Stormgears-FRC-5422/StormNet/2018/The Story/IMG_0521.jpg

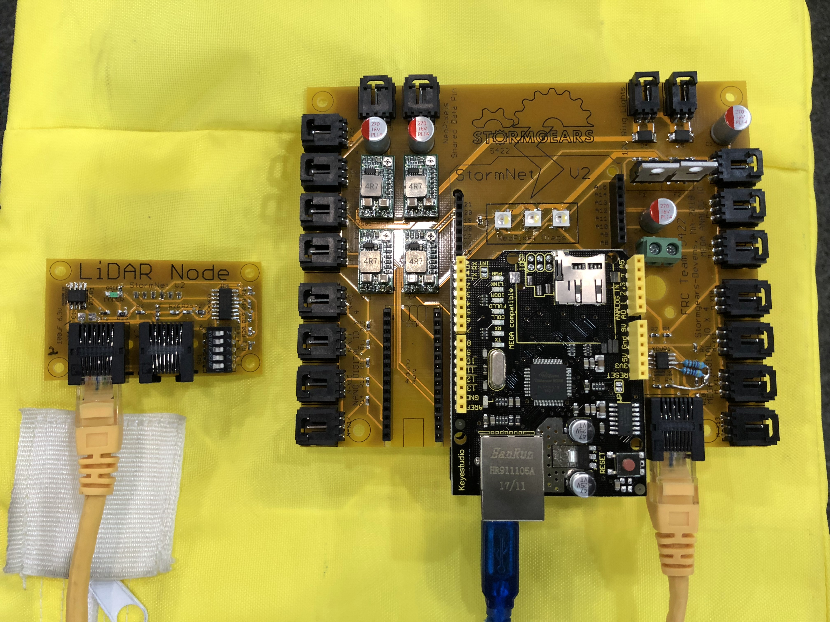
2018/The Story/IMG_0521.jpg
