Stormgears-FRC-5422/StormNet/README.md

# StormNet
Electrical schematics and other files related to the StormNet sensor board
