Stormgears-FRC-5422/StormNet/2020/StormNetGenericNodeSchematic.pdf

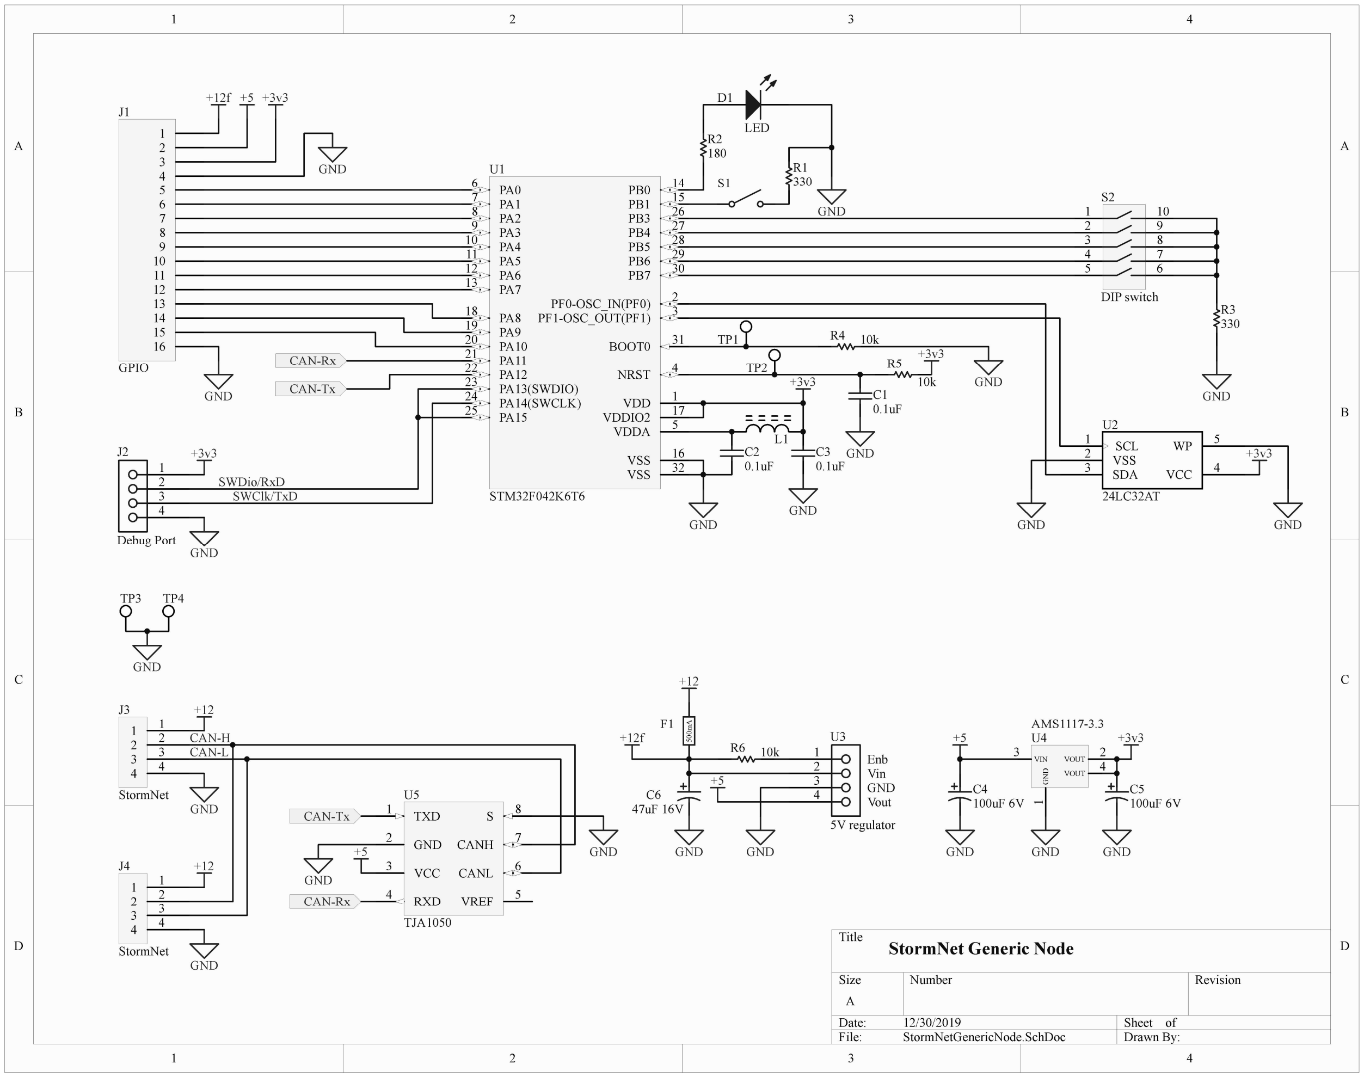
[picture p7: page 1]

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
Title

Size | Number | Revision
A
Date: | 12/30/2019 | Sheet of
File: | StormNetGenericNode.SchDoc | Drawn By:

PA0 6
PA1 7
PA2 8
PA3 9
PA4 10
PA5 11
PA6 12
PA7 13

PA8 18
PA9 19
PA10 20
PA11 21
PA12 22
PA13(SWDIO) 23
PA14(SWCLK) 24
PA15 25
PB0 | 14
PB1 | 15
PB3 | 26
PB4 | 27
PB5 | 28
PB6 | 29
PB7 | 30
BOOT0 | 31
NRST | 4
PF0-OSC_IN(PF0) | 2
PF1-OSC_OUT(PF1) | 3
VDD | 1
VDDA | 5
VSS | 16
VDDIO2 | 17
VSS | 32

U1

STM32F042K6T6

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
GPIO

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
StormNet

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
StormNet

1
2
3
4

J2

Debug Port

1
2
3
4

U3

5V regulator

VIN

3
VOUT

### 2 GND

1

VOUT

4

U4

AMS1117-3.3

TXD 1

GND 2

VCC 3

RXD 4 | VREF | 5
| CANL | 6
CANH | 7
S | 8

U5

TJA1050

D1

LED

R3
330

C2
0.1uF

C5
100uF 6V

+12f +5 +3v3

GND

GND

+3v3

SWDio/RxD
SWClk/TxD

GND

GND

+12

+12

CAN-H
CAN-L

CAN-Rx

CAN-Tx

+5

GND

CAN-Tx

CAN-Rx

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
DIP switch

GND

GND

+3v3

TP1

TP2

L1

R5
10k

R4 10k

GND

C3
0.1uF

SCL 1
VSS 2
SDA 3 | VCC | 4
| WP | 5

U2

24LC32AT

+3v3

GND | GND

GND

GND

+3v3

GND

+5

C4
100uF 6V

GND

Enb
Vin
GND
Vout

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
0.1uF

GND

+3v3

R6 10k

GND

TP3 | TP4 | 500mAF1

S1

## StormNet Generic Node

+12f

C6
47uF 16V

GND
