Stormgears-FRC-5422/StormNet/2018/StormNetV2-FinalDocs/StormNet Board/BOM.csv

Part | Value | Device | Package | DescriptionMF | MPN | OC_FARNELL | OC_NEWARK | PROD_ID | VALUE
C1 | 270uF 16V | CPOL-USE3.5-8 | E3,5-8 | POLARIZED CAPACITOR, American symbol
C2 | 270uF 16V | CPOL-USE3.5-8 | E3,5-8 | POLARIZED CAPACITOR, American symbol
C3 | 270uF 16V | CPOL-USE3.5-8 | E3,5-8 | POLARIZED CAPACITOR, American symbol
C4 | 270uF 16V | CPOL-USE3.5-8 | E3,5-8 | POLARIZED CAPACITOR, American symbol
D1 | WS2812B | WS2812B | WS2812B | WS2812B SMD addressable RGB LED |  |  |  |  | DIO-12503
D2 | WS2812B | WS2812B | WS2812B | WS2812B SMD addressable RGB LED |  |  |  |  | DIO-12503
D3 | WS2812B | WS2812B | WS2812B | WS2812B SMD addressable RGB LED |  |  |  |  | DIO-12503
D4 | 1N5822 | DIODESMA | SMADIODE | Diode
D5 | 1N5822 | DIODESMA | SMADIODE | Diode
F1 | IRLZ44 | IRLZ44 | IRLZ44-TO220
F2 | IRLZ44 | IRLZ44 | IRLZ44-TO220
M-X6 | HEADER_POS3_70555 | HEADER_POS3_70555 | 70555-POS3 | Molex -C-Grid® / SL Series connector
M-X7 | HEADER_POS3_70555 | HEADER_POS3_70555 | 70555-POS3 | Molex -C-Grid® / SL Series connector
M-X8 | HEADER_POS3_70555 | HEADER_POS3_70555 | 70555-POS3 | Molex -C-Grid® / SL Series connector
M-X10 | HEADER_POS3_70555 | HEADER_POS3_70555 | 70555-POS3 | Molex -C-Grid® / SL Series connector
M-X11 | HEADER_POS3_70555 | HEADER_POS3_70555 | 70555-POS3 | Molex -C-Grid® / SL Series connector
M-X12 | HEADER_POS3_70555 | HEADER_POS3_70555 | 70555-POS3 | Molex -C-Grid® / SL Series connector
M-X13 | HEADER_POS3_70555 | HEADER_POS3_70555 | 70555-POS3 | Molex -C-Grid® / SL Series connector
N-PIX-X18 | HEADER_POS3_70555 | HEADER_POS3_70555 | 70555-POS3 | Molex -C-Grid® / SL Series connector
N-PIX-X19 | HEADER_POS3_70555 | HEADER_POS3_70555 | 70555-POS3 | Molex -C-Grid® / SL Series connector
N-X2 | HEADER_POS3_70555 | HEADER_POS3_70555 | 70555-POS3 | Molex -C-Grid® / SL Series connector
N-X3 | HEADER_POS3_70555 | HEADER_POS3_70555 | 70555-POS3 | Molex -C-Grid® / SL Series connector
N-X4 | HEADER_POS3_70555 | HEADER_POS3_70555 | 70555-POS3 | Molex -C-Grid® / SL Series connector
N-X5 | HEADER_POS3_70555 | HEADER_POS3_70555 | 70555-POS3 | Molex -C-Grid® / SL Series connector
N-X14 | HEADER_POS3_70555 | HEADER_POS3_70555 | 70555-POS3 | Molex -C-Grid® / SL Series connector
N-X15 | HEADER_POS3_70555 | HEADER_POS3_70555 | 70555-POS3 | Molex -C-Grid® / SL Series connector
N-X16 | HEADER_POS3_70555 | HEADER_POS3_70555 | 70555-POS3 | Molex -C-Grid® / SL Series connector
N-X17 | HEADER_POS3_70555 | HEADER_POS3_70555 | 70555-POS3 | Molex -C-Grid® / SL Series connector
PCB2 | ARDUINO_MEGA2560_SMALL | ARDUINO_MEGA2560_SMALL | ARDUINO_MEGA2560_SMALL | Device for representing an Arduino Mega 2560 board with a footprint in an EAGLE design. Created by Dave Young for Element14. More EAGLE documentation at: http://www.element14.com/community/community/knode/cadsoft_eagle
PCB3 | ARDUINO_NANOWITHOUT_ICSP | ARDUINO_NANOWITHOUT_ICSP | ARDUINO_NANO | Device for representing an Arduino Nano board with a footprint in an EAGLE design. Created by Dave Young for Element14. More EAGLE documentation at: http://www.element14.com/community/community/knode/cadsoft_eagle
R1 | 2.7K | R-US_R0603 | R0603 | RESISTOR, American symbol
R2 | 2.7K | R-US_R0603 | R0603 | RESISTOR, American symbol
R3 | 1K | R-US_R0603 | R0603 | RESISTOR, American symbol
R4 | 150R | R-US_R0603 | R0603 | RESISTOR, American symbol
R5 | 150R | R-US_R0603 | R0603 | RESISTOR, American symbol
R6 | 150R | R-US_R0603 | R0603 | RESISTOR, American symbol
R7 | 150R | R-US_R0603 | R0603 | RESISTOR, American symbol
R8 | 150R | R-US_R0603 | R0603 | RESISTOR, American symbol
R9 | 150R | R-US_R0603 | R0603 | RESISTOR, American symbol
R10 | 150R | R-US_R0603 | R0603 | RESISTOR, American symbol
R11 | 150R | R-US_R0603 | R0603 | RESISTOR, American symbol
R12 | 150R | R-US_R0603 | R0603 | RESISTOR, American symbol
R13 | 150R | R-US_R0603 | R0603 | RESISTOR, American symbol
R14 | 150R | R-US_R0603 | R0603 | RESISTOR, American symbol
R15 | 150R | R-US_R0603 | R0603 | RESISTOR, American symbol
R16 | 150R | R-US_R0603 | R0603 | RESISTOR, American symbol
R17 | 150R | R-US_R0603 | R0603 | RESISTOR, American symbol
R24 | 150R | R-US_R0603 | R0603 | RESISTOR, American symbol
SV1 | +5VDC | SUPPLY-UNIV-EFFICIENT | PS-UNIV-EFFICIENT-3A | PIN HEADER |  |  | unknown | unknown
SV2 | +5VDC | SUPPLY-UNIV-EFFICIENT | PS-UNIV-EFFICIENT-3A | PIN HEADER |  |  | unknown | unknown
SV3 | +5VDC | SUPPLY-UNIV-EFFICIENT | PS-UNIV-EFFICIENT-3A | PIN HEADER |  |  | unknown | unknown
SV4 | +5VDC | SUPPLY-UNIV-EFFICIENT | PS-UNIV-EFFICIENT-3A | PIN HEADER |  |  | unknown | unknown
X1 | RJ45-8X | RJ45-8X | RJ45-NO-SHIELD | CORCOM Modular RJ Jacks No Shield |  | RJ45-8X | unknown | 16R6101
X2 | FROM RRIO | MSTBV2 | MSTBV2-SMALL | PHOENIX
X3 | HEADER_POS2_70555 | HEADER_POS2_70555 | 70555-POS2 | Molex -C-Grid® / SL Series connector
X4 | HEADER_POS2_70555 | HEADER_POS2_70555 | 70555-POS2 | Molex -C-Grid® / SL Series connector
XCVR1 | PCA9600DSO8 | PCA9600DSO8 | SO08 | NXP PCA9600 I2C long distance driver
