Stormgears-FRC-5422/StormNet/2017/StormNet 3X Board/Demo Case/Cutting Files/Board Mount Panel^Demo Case Assembly.DXF

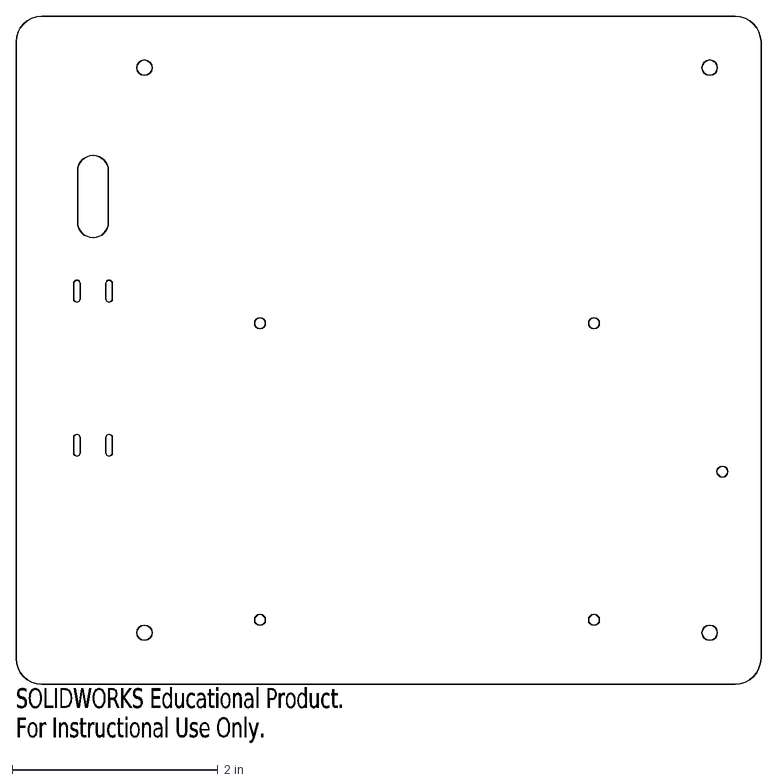
[picture p12: CAD file, 2020-01-03]
2017/StormNet 3X Board/Demo Case/Cutting Files/Board Mount Panel^Demo Case Assembly.DXF
SOLIDWORKS Educational Product.
For Instructional Use Only.
