Stormgears-FRC-5422/StormNet/2017/StormNet 3X Board/Demo Case/Cutting Files/Bottom^Demo Case Assembly.DXF

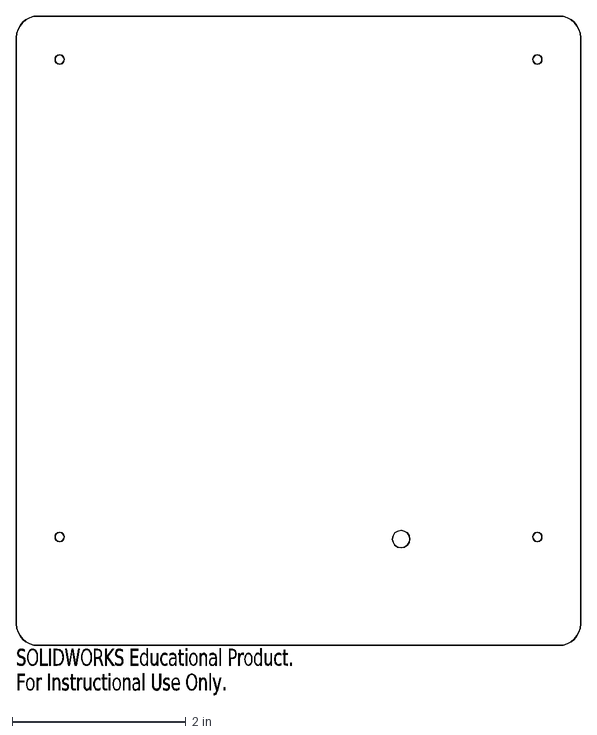
[picture p13: CAD file, 2020-01-03]
2017/StormNet 3X Board/Demo Case/Cutting Files/Bottom^Demo Case Assembly.DXF
SOLIDWORKS Educational Product.
For Instructional Use Only.
