Stormgears-FRC-5422/StormNet/2017/StormNet 3X Board/Demo Case/Anker USB charger.SLDASM

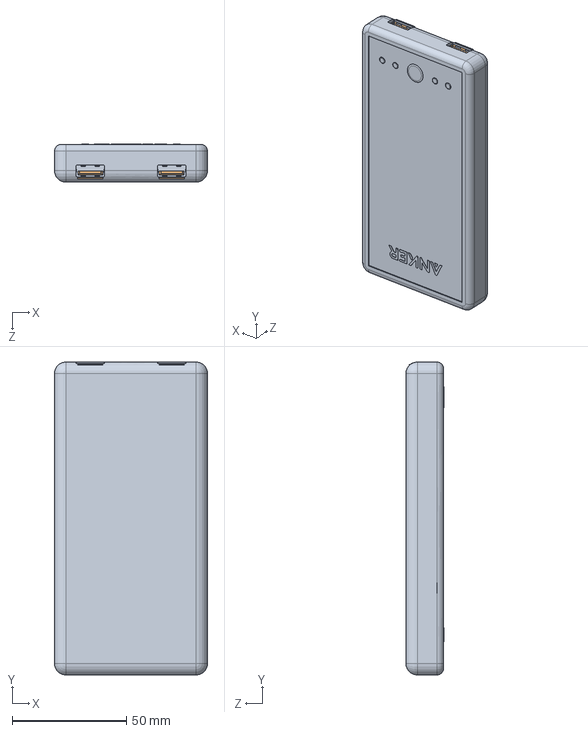
[picture p15: CAD file, 2020-01-03]
2017/StormNet 3X Board/Demo Case/Anker USB charger.SLDASM
67.0 x 137.0 x 16.8 mm
Anker Astro E3
USB Type A - panel mount x 2
