Stormgears-FRC-5422/StormNet/2017/StormNet 3X Board/arduino nano290313/reset button.SLDASM

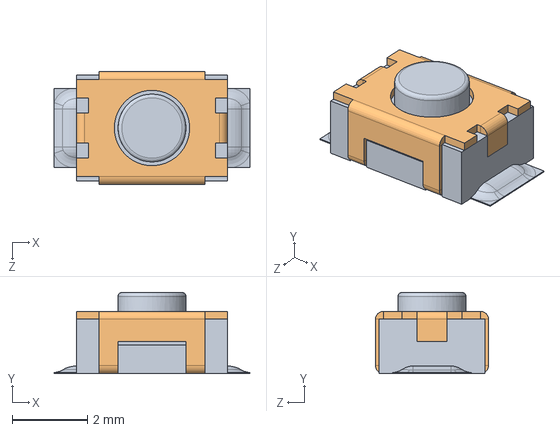
[picture p16: CAD file, 2020-01-03]
2017/StormNet 3X Board/arduino nano290313/reset button.SLDASM
5.20 x 2.15 x 3.00 mm
reset core
reset shell
