Stormgears-FRC-5422/StormNet/2017/StormNet 3X Board/Demo Case/Demo Case Assembly.SLDASM

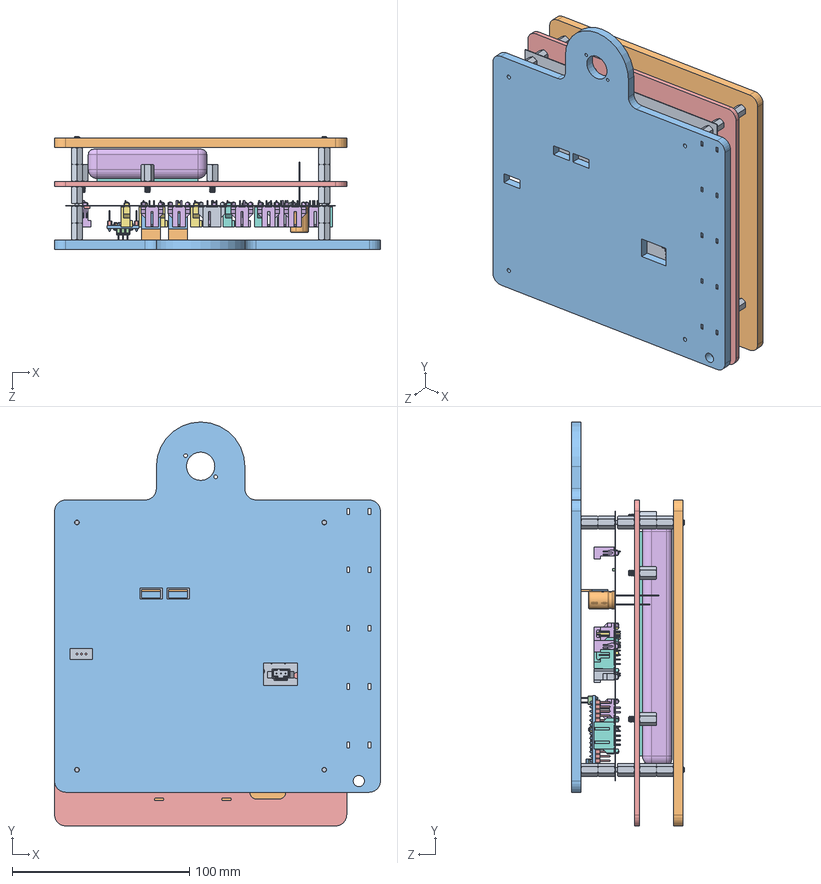
[picture p17: CAD file, 2020-01-03]
2017/StormNet 3X Board/Demo Case/Demo Case Assembly.SLDASM
184.2 x 228.2 x 64.0 mm
Board
Extruded x 2
Extruded_2 x 2
Extruded_3 x 8
Extruded_4 x 2
Molex-SL-2P x 10
Molex-SL-4P x 5
Molex-SL-5P x 3
Molex-SL-3P x 4
1000uF_16V
nano-board
2pin_header__02 x 3
15pin_header__ x 2
atmega328
ftdi FT232rl
smt_resistor222 x 5
led x 4
16mhz crystal - measured
MINIUSBSHELL
MINIUSBCORE
MINI USB CONTACT x 5
cap106C x 2
reset core
reset shell
nano - reg
NANO DIODE
189 RESISTOR PACK
102 RESISTOR PACK
Board Mount Panel^Demo Case Assembly
Anker Astro E3
USB Type A - panel mount x 2
Foam Pad^Demo Case Assembly
6-32x0.375_ALUM MALE-FEM THRDED HEX STANDOFF x 25
Bottom^Demo Case Assembly
Top Cover^Demo Case Assembly
