Stormgears-FRC-5422/StormNet/2017/StormNet 3X Board/arduino nano290313/MINIUSB - MEASURED.SLDASM

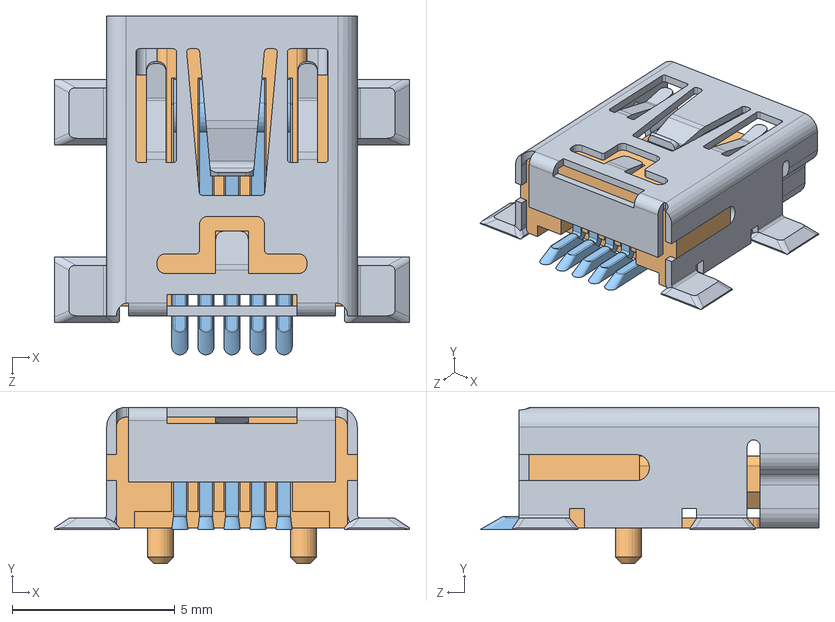
[picture p18: CAD file, 2020-01-03]
2017/StormNet 3X Board/arduino nano290313/MINIUSB - MEASURED.SLDASM
10.9 x 4.80 x 10.4 mm
MINIUSBSHELL
MINIUSBCORE
MINI USB CONTACT x 5
