Stormgears-FRC-5422/StormNet/2017/StormNet 3X Board/arduino nano290313/2pin_header__02.sldprt

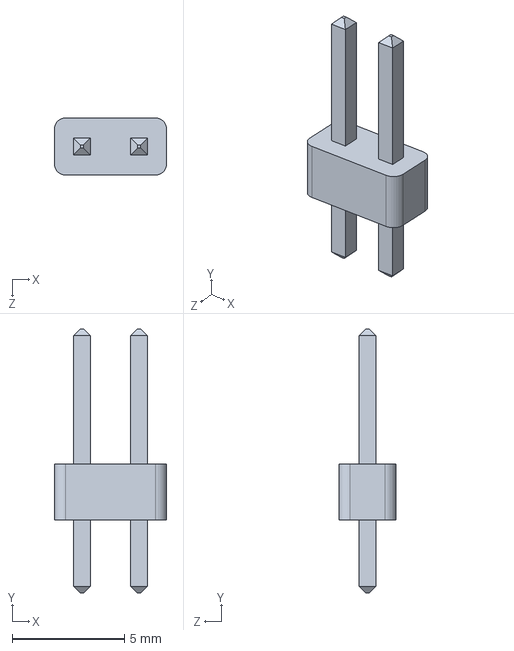
[picture p20: CAD file, 2020-01-03]
2017/StormNet 3X Board/arduino nano290313/2pin_header__02.sldprt
5.00 x 11.8 x 2.54 mm
