Stormgears-FRC-5422/StormNet/2017/StormNet 3X Board/Demo Case/10mm_MALE-FEM THRDED HEX STANDOFF.SLDPRT

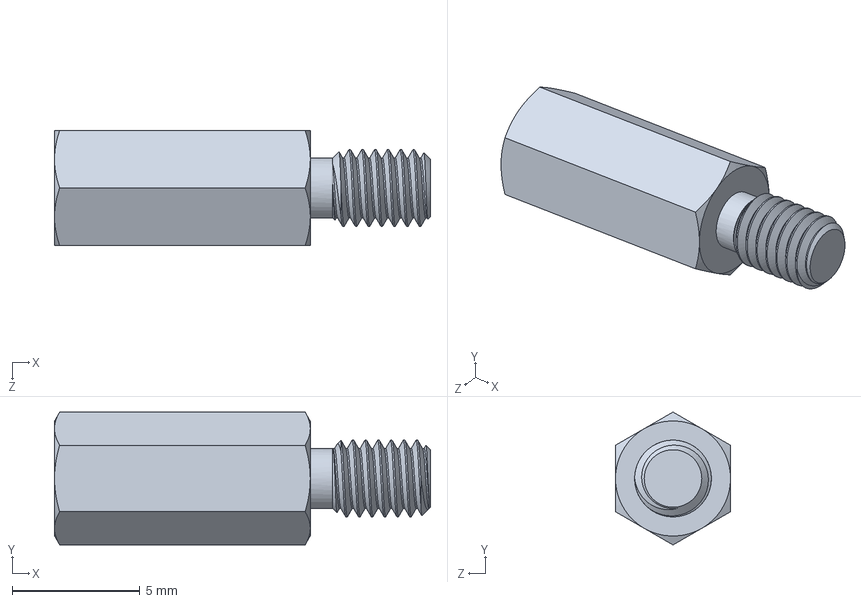
[picture p21: CAD file, 2020-01-03]
2017/StormNet 3X Board/Demo Case/10mm_MALE-FEM THRDED HEX STANDOFF.SLDPRT
14.7 x 5.20 x 4.50 mm
