Stormgears-FRC-5422/StormNet/2017/StormNet 3X Board/StormNet Board Project/Outputs/StormNet PCB-BigHoles-v1.3.step

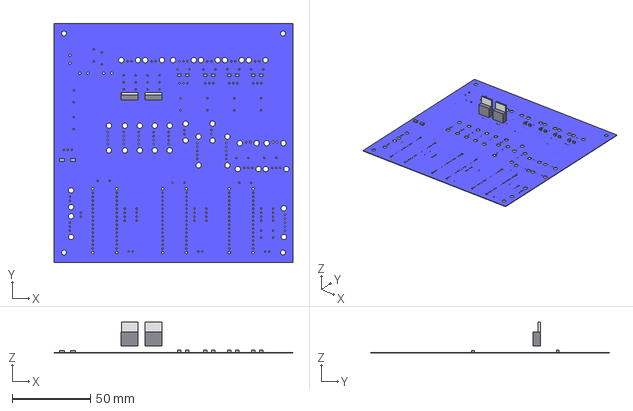
[picture p22: CAD file, 2020-01-03]
2017/StormNet 3X Board/StormNet Board Project/Outputs/StormNet PCB-BigHoles-v1.3.step
152.4 x 152.4 x 19.7 mm
BoardStormNet_PCB-BigHoles
Extruded x 14
