Stormgears-FRC-5422/StormNet/2018/StormNet18Eagle-v1/ArduinoMega.SLDPRT

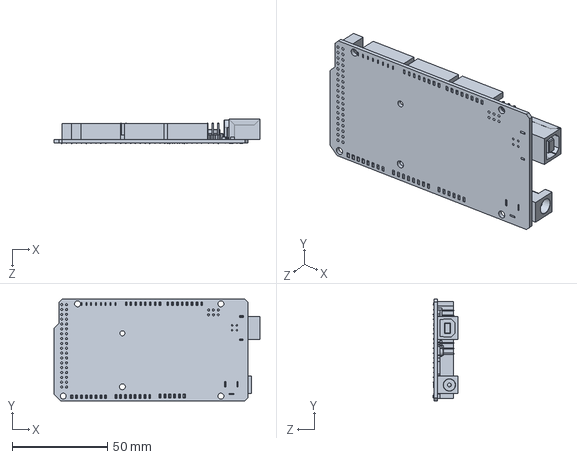
[picture p23: CAD file, 2020-01-03]
2018/StormNet18Eagle-v1/ArduinoMega.SLDPRT
107.9 x 53.4 x 13.0 mm
