Stormgears-FRC-5422/StormNet/2017/StormNet 3X Board/arduino nano290313/189 RESISTOR PACK.SLDPRT

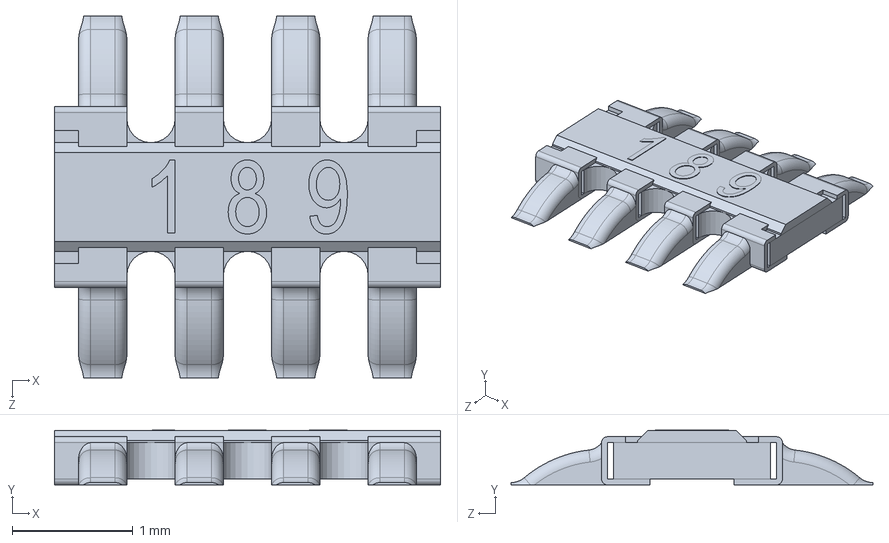
[picture p24: CAD file, 2020-01-03]
2017/StormNet 3X Board/arduino nano290313/189 RESISTOR PACK.SLDPRT
3.20 x 0.455 x 3.00 mm
