Stormgears-FRC-5422/StormNet/2017/StormNet 3X Board/Demo Case/6-32x0.375_ALUM MALE-FEM THRDED HEX STANDOFF.SLDPRT

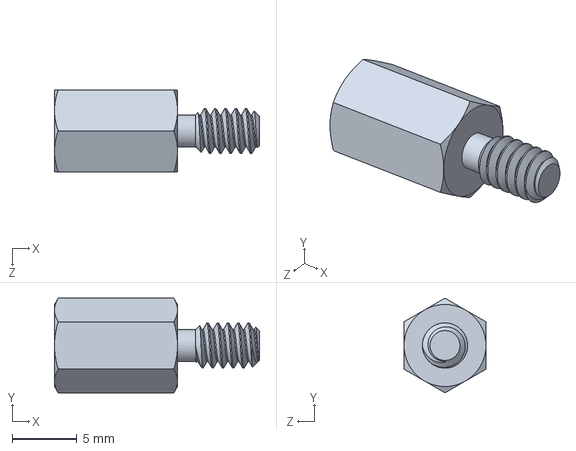
[picture p25: CAD file, 2020-01-03]
2017/StormNet 3X Board/Demo Case/6-32x0.375_ALUM MALE-FEM THRDED HEX STANDOFF.SLDPRT
15.9 x 7.33 x 6.35 mm
