Stormgears-FRC-5422/StormNet/2017/StormNet 3X Board/arduino nano290313/reset shell.SLDPRT

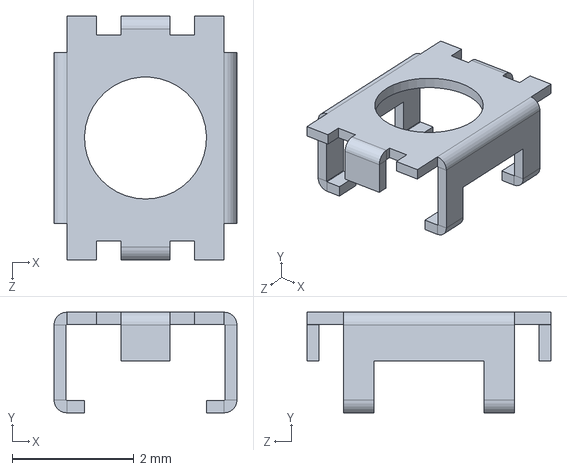
[picture p26: CAD file, 2020-01-03]
2017/StormNet 3X Board/arduino nano290313/reset shell.SLDPRT
3.00 x 1.65 x 4.00 mm
