Stormgears-FRC-5422/StormNet/2017/StormNet 3X Board/Demo Case/Anker Astro E3.sldprt

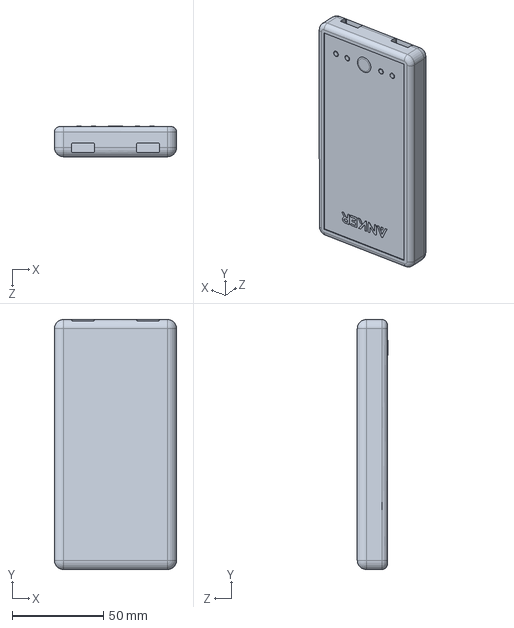
[picture p27: CAD file, 2020-01-03]
2017/StormNet 3X Board/Demo Case/Anker Astro E3.sldprt
67.0 x 137.0 x 16.8 mm
