Stormgears-FRC-5422/StormNet/2017/StormNet 3X Board/Molex-SL-5P.SLDPRT

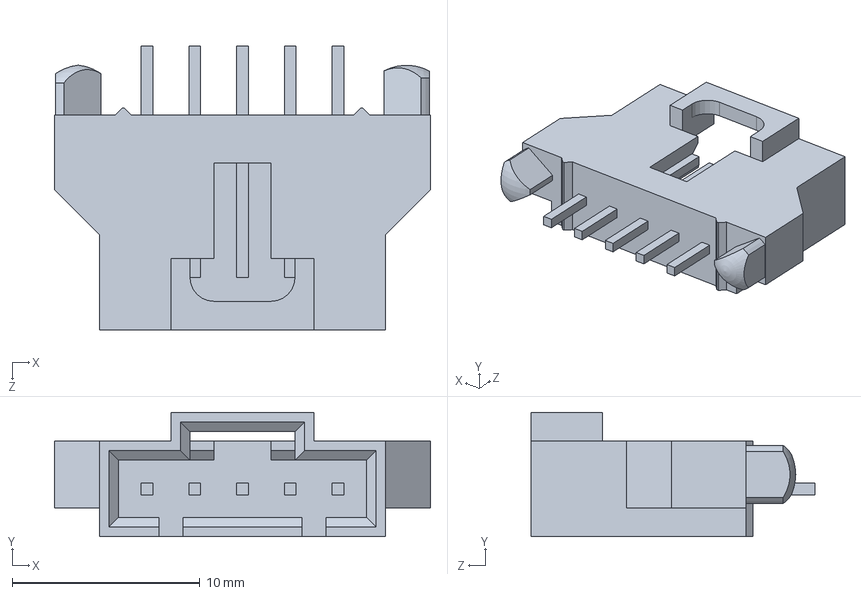
[picture p28: CAD file, 2020-01-03]
2017/StormNet 3X Board/Molex-SL-5P.SLDPRT
20.0 x 6.60 x 15.1 mm
