Stormgears-FRC-5422/StormNet/2017/StormNet 3X Board/arduino nano290313/atmega328.SLDPRT

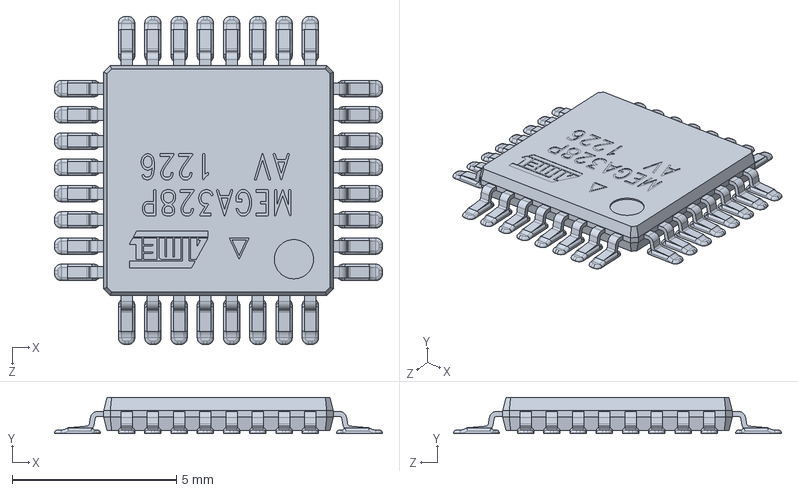
[picture p29: CAD file, 2020-01-03]
2017/StormNet 3X Board/arduino nano290313/atmega328.SLDPRT
10.0 x 1.10 x 10.0 mm
