Stormgears-FRC-5422/StormNet/2017/StormNet 3X Board/Demo Case/USB Type A - panel mount.SLDPRT

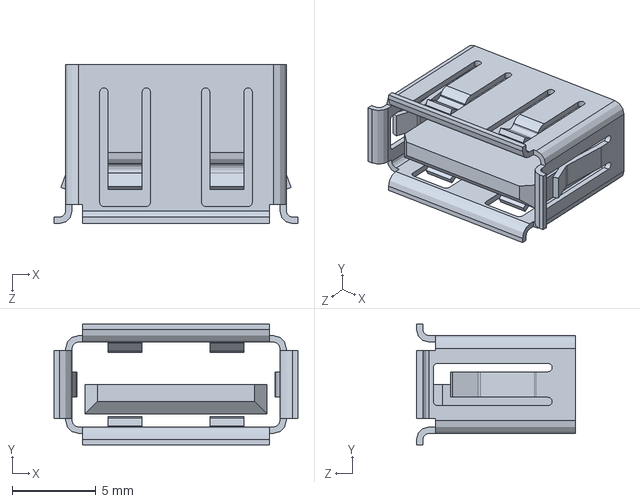
[picture p30: CAD file, 2020-01-03]
2017/StormNet 3X Board/Demo Case/USB Type A - panel mount.SLDPRT
14.6 x 7.24 x 9.53 mm
