Stormgears-FRC-5422/StormNet/2017/StormNet 3X Board/arduino nano290313/MINI USB CONTACT.SLDPRT

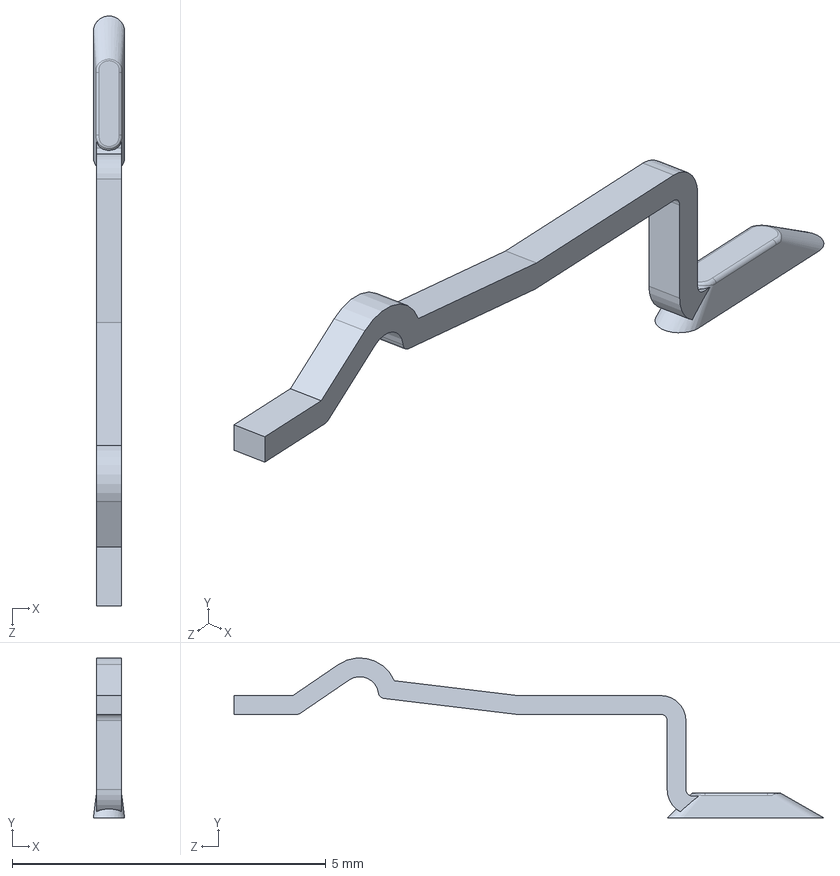
[picture p31: CAD file, 2020-01-03]
2017/StormNet 3X Board/arduino nano290313/MINI USB CONTACT.SLDPRT
0.5 x 2.55 x 9.40 mm
