Stormgears-FRC-5422/StormNet/2017/StormNet 3X Board/1000uF_16V.SLDPRT

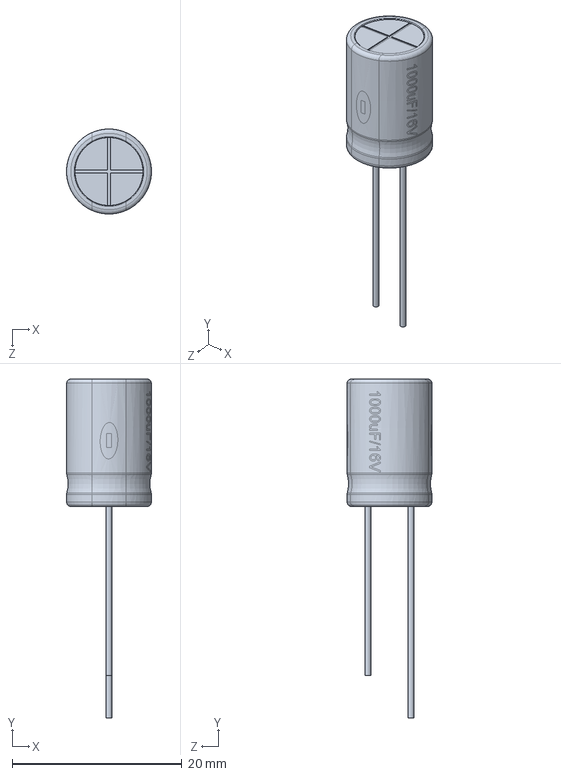
[picture p32: CAD file, 2020-01-03]
2017/StormNet 3X Board/1000uF_16V.SLDPRT
10.0 x 39.9 x 10.0 mm
