Stormgears-FRC-5422/StormNet/2017/StormNet 3X Board/arduino nano290313/16mhz crystal - measured.SLDPRT

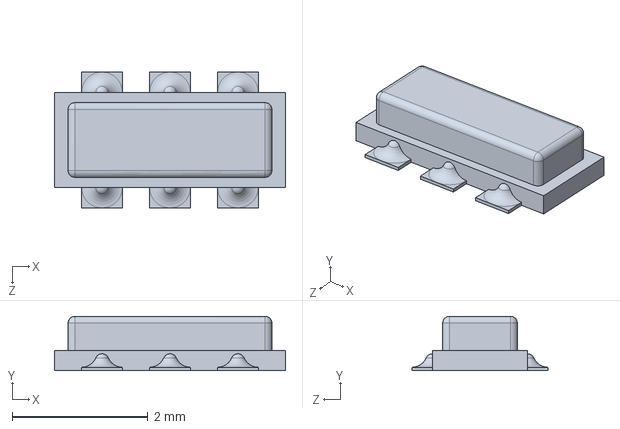
[picture p33: CAD file, 2020-01-03]
2017/StormNet 3X Board/arduino nano290313/16mhz crystal - measured.SLDPRT
3.40 x 0.8 x 2.00 mm
