Stormgears-FRC-5422/StormNet/2017/StormNet 3X Board/Demo Case/5mm_MALE-FEM THRDED HEX STANDOFF.SLDPRT

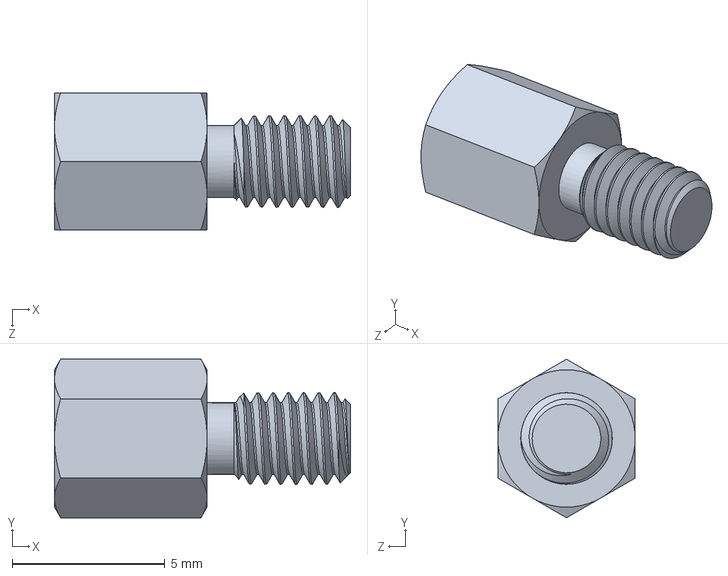
[picture p34: CAD file, 2020-01-03]
2017/StormNet 3X Board/Demo Case/5mm_MALE-FEM THRDED HEX STANDOFF.SLDPRT
9.70 x 5.20 x 4.50 mm
