Stormgears-FRC-5422/StormNet/2017/StormNet 3X Board/arduino nano290313/15pin_header__.sldprt

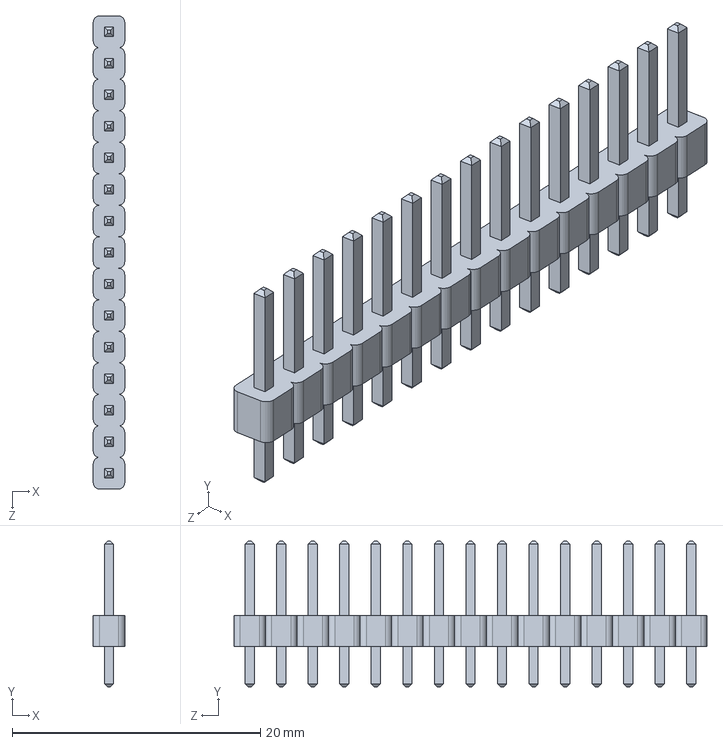
[picture p35: CAD file, 2020-01-03]
2017/StormNet 3X Board/arduino nano290313/15pin_header__.sldprt
2.54 x 11.8 x 38.1 mm
