Stormgears-FRC-5422/StormNet/2017/StormNet 3X Board/Molex-SL-4P.SLDPRT

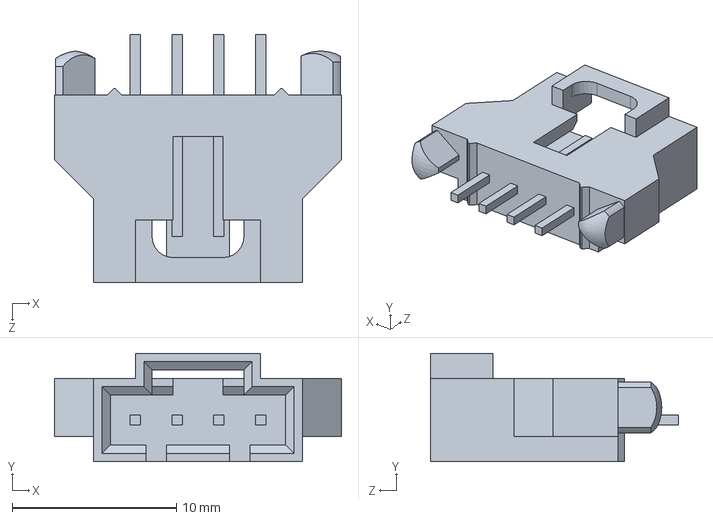
[picture p37: CAD file, 2020-01-03]
2017/StormNet 3X Board/Molex-SL-4P.SLDPRT
17.5 x 6.60 x 15.1 mm
