Stormgears-FRC-5422/StormNet/2017/StormNet 3X Board/arduino nano290313/led.SLDPRT

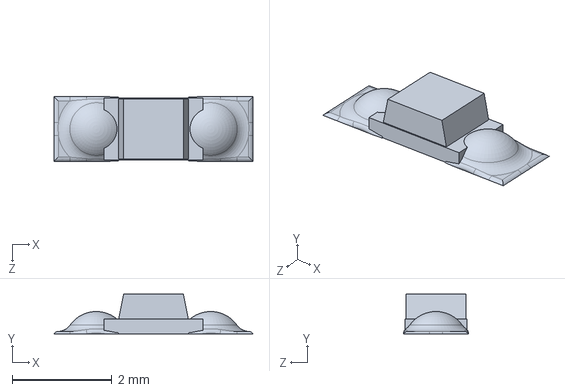
[picture p38: CAD file, 2020-01-03]
2017/StormNet 3X Board/arduino nano290313/led.SLDPRT
4.00 x 0.8 x 1.30 mm
