Stormgears-FRC-5422/StormNet/2017/StormNet 3X Board/Demo Case/6-32x.25in_ALUM MALE-FEM THRDED HEX STANDOFF.SLDPRT

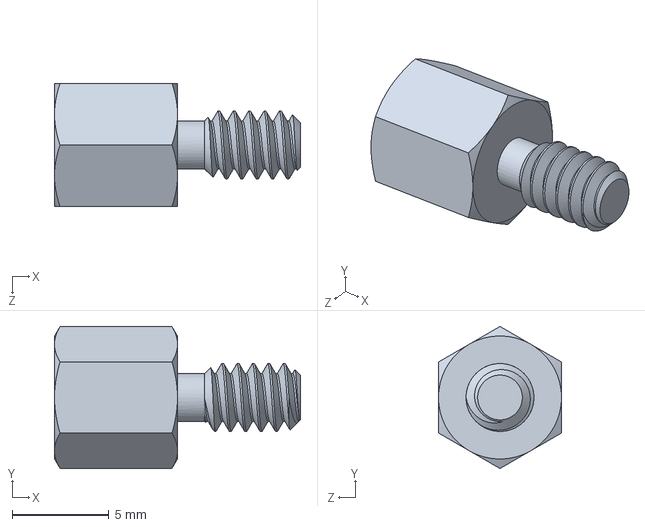
[picture p39: CAD file, 2020-01-03]
2017/StormNet 3X Board/Demo Case/6-32x.25in_ALUM MALE-FEM THRDED HEX STANDOFF.SLDPRT
12.7 x 7.33 x 6.35 mm
