Stormgears-FRC-5422/StormNet/2017/StormNet 3X Board/arduino nano290313/MINIUSBCORE.SLDPRT

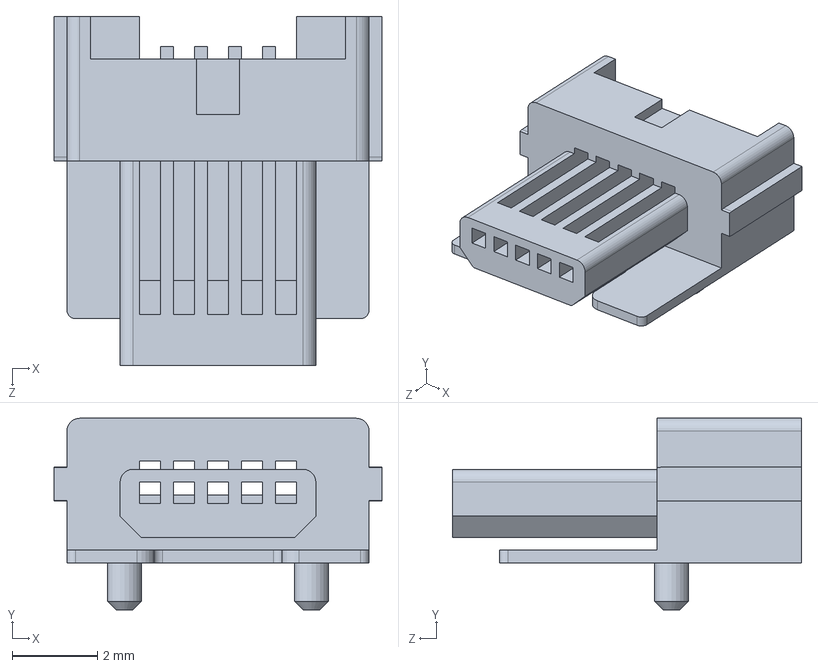
[picture p40: CAD file, 2020-01-03]
2017/StormNet 3X Board/arduino nano290313/MINIUSBCORE.SLDPRT
7.70 x 4.50 x 8.20 mm
