Stormgears-FRC-5422/StormNet/2017/StormNet 3X Board/Molex-SL-3P.SLDPRT

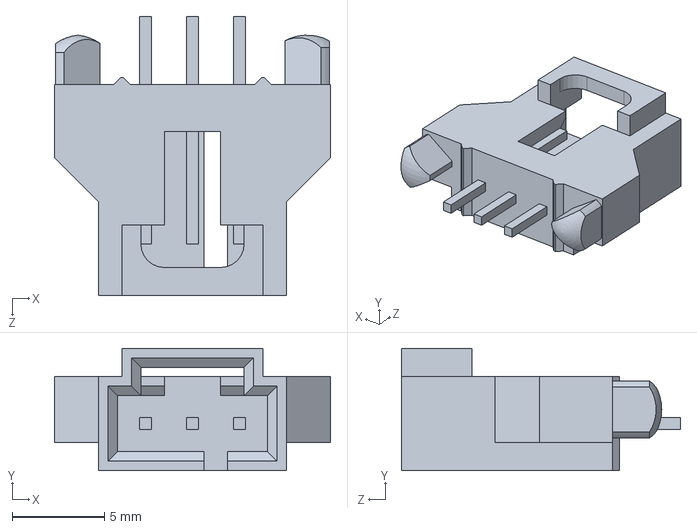
[picture p41: CAD file, 2020-01-03]
2017/StormNet 3X Board/Molex-SL-3P.SLDPRT
14.9 x 6.60 x 15.1 mm
