Stormgears-FRC-5422/StormNet/2017/StormNet 3X Board/arduino nano290313/ftdi FT232rl.SLDPRT

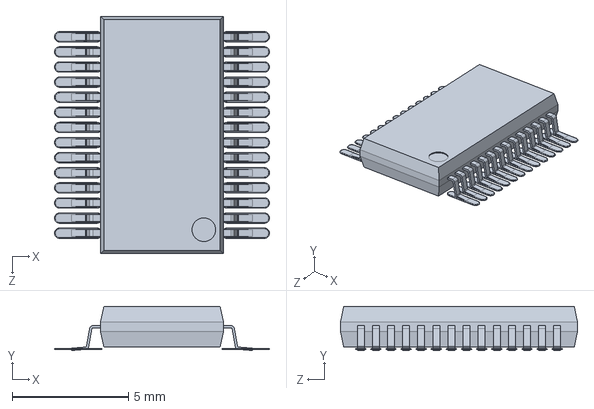
[picture p42: CAD file, 2020-01-03]
2017/StormNet 3X Board/arduino nano290313/ftdi FT232rl.SLDPRT
9.25 x 1.90 x 10.2 mm
