Stormgears-FRC-5422/StormNet/2017/StormNet 3X Board/arduino nano290313/NANO DIODE.SLDPRT

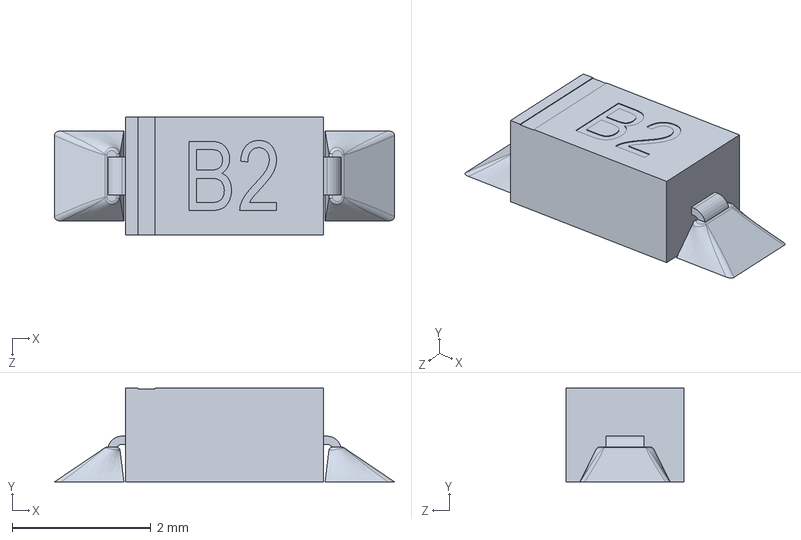
[picture p43: CAD file, 2020-01-03]
2017/StormNet 3X Board/arduino nano290313/NANO DIODE.SLDPRT
4.90 x 1.35 x 1.70 mm
