Stormgears-FRC-5422/StormNet/2017/StormNet 3X Board/arduino nano290313/smt_resistor222.sldprt

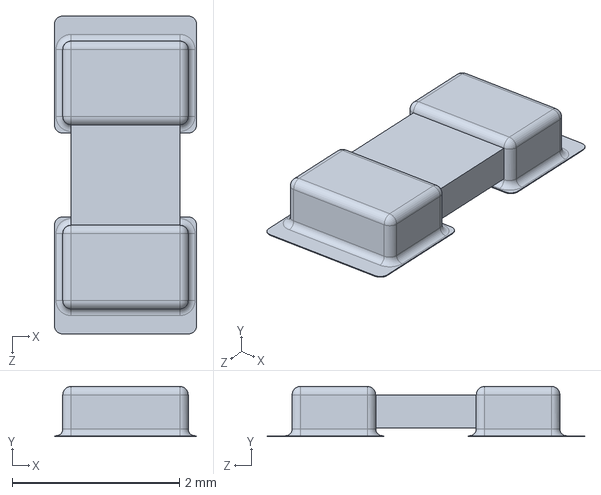
[picture p44: CAD file, 2020-01-03]
2017/StormNet 3X Board/arduino nano290313/smt_resistor222.sldprt
1.70 x 0.6 x 3.80 mm
