Stormgears-FRC-5422/StormNet/2017/StormNet 3X Board/arduino nano290313/reset core.SLDPRT

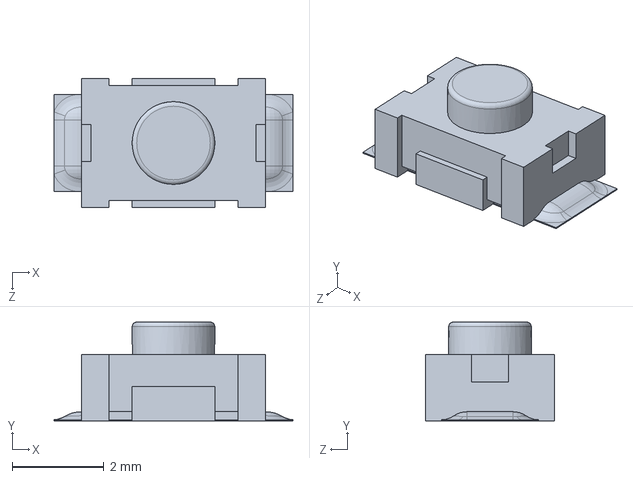
[picture p45: CAD file, 2020-01-03]
2017/StormNet 3X Board/arduino nano290313/reset core.SLDPRT
5.20 x 2.15 x 2.80 mm
