Stormgears-FRC-5422/StormNet/2017/StormNet 3X Board/arduino nano290313/nano-board.SLDPRT

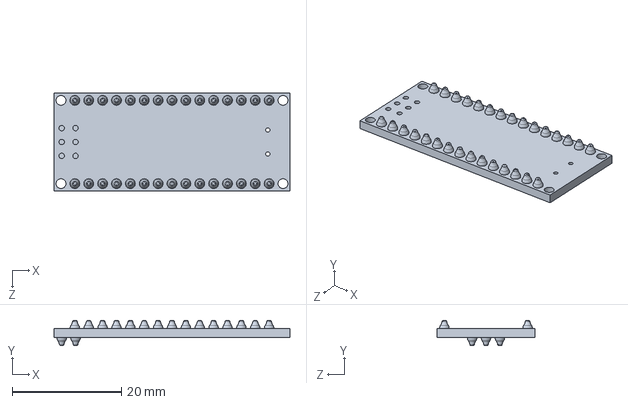
[picture p46: CAD file, 2020-01-03]
2017/StormNet 3X Board/arduino nano290313/nano-board.SLDPRT
43.2 x 4.60 x 18.0 mm
