Stormgears-FRC-5422/StormNet/2017/StormNet 3X Board/arduino nano290313/MINI USB SOLDER.SLDPRT

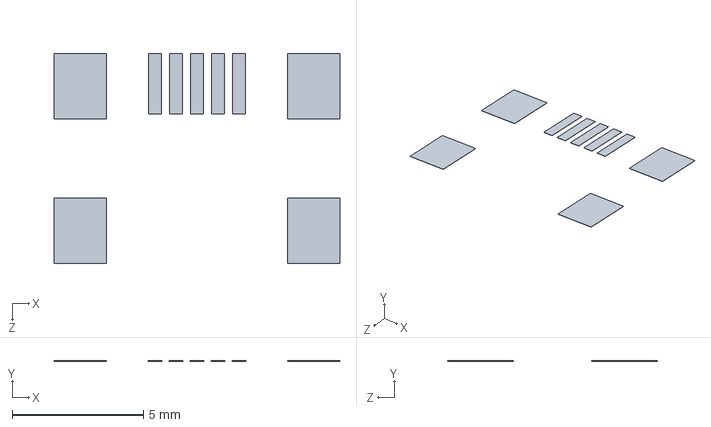
[picture p47: CAD file, 2020-01-03]
2017/StormNet 3X Board/arduino nano290313/MINI USB SOLDER.SLDPRT
10.9 x 0.01 x 8.00 mm
