Stormgears-FRC-5422/StormNet/2017/StormNet 3X Board/arduino nano290313/MINIUSBSHELL.SLDPRT

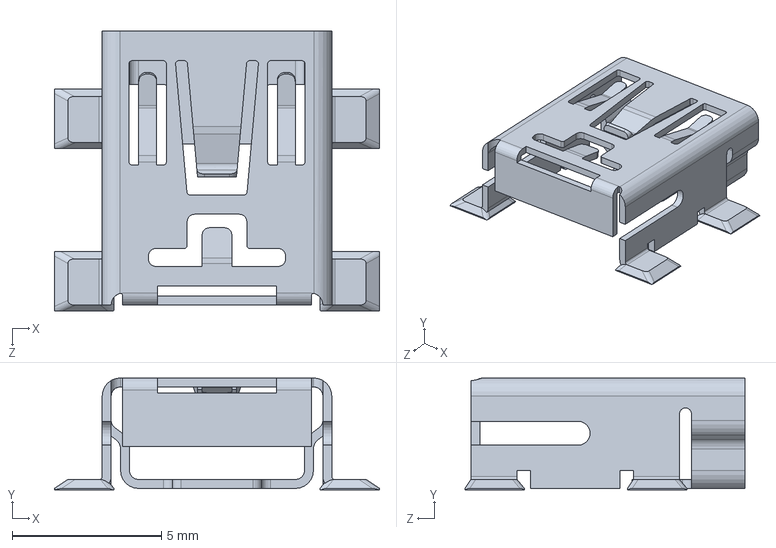
[picture p48: CAD file, 2020-01-03]
2017/StormNet 3X Board/arduino nano290313/MINIUSBSHELL.SLDPRT
10.9 x 3.75 x 9.40 mm
