Stormgears-FRC-5422/StormNet/2017/StormNet 3X Board/arduino nano290313/cap106C.SLDPRT

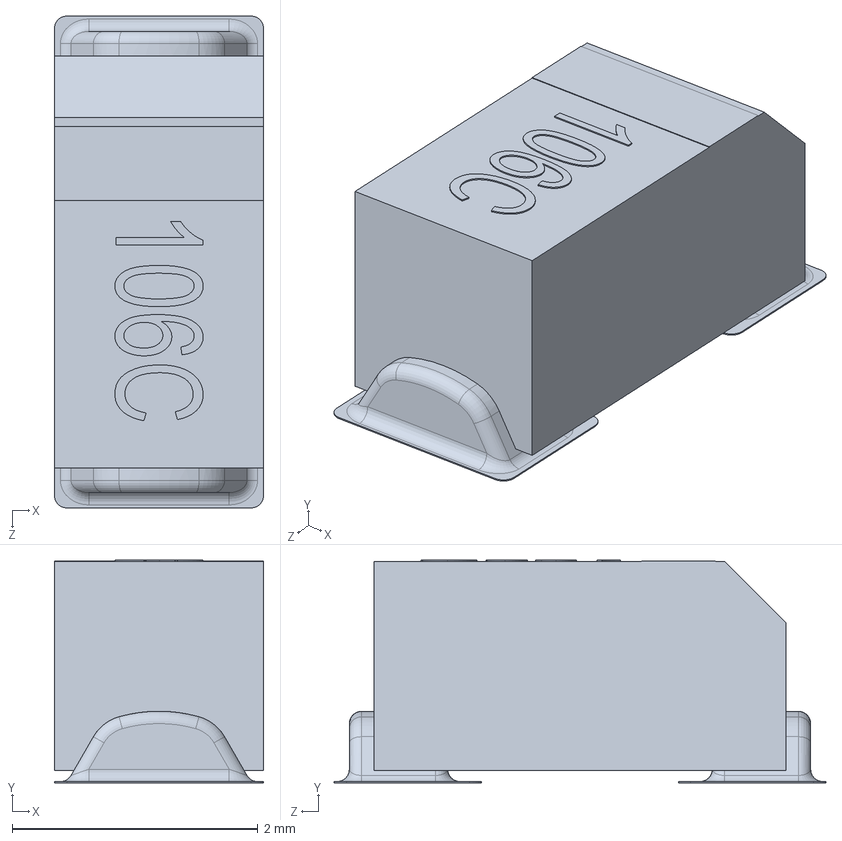
[picture p49: CAD file, 2020-01-03]
2017/StormNet 3X Board/arduino nano290313/cap106C.SLDPRT
1.70 x 1.81 x 4.00 mm
