Stormgears-FRC-5422/StormNet/2017/StormNet 3X Board/Molex-SL-2P.SLDPRT

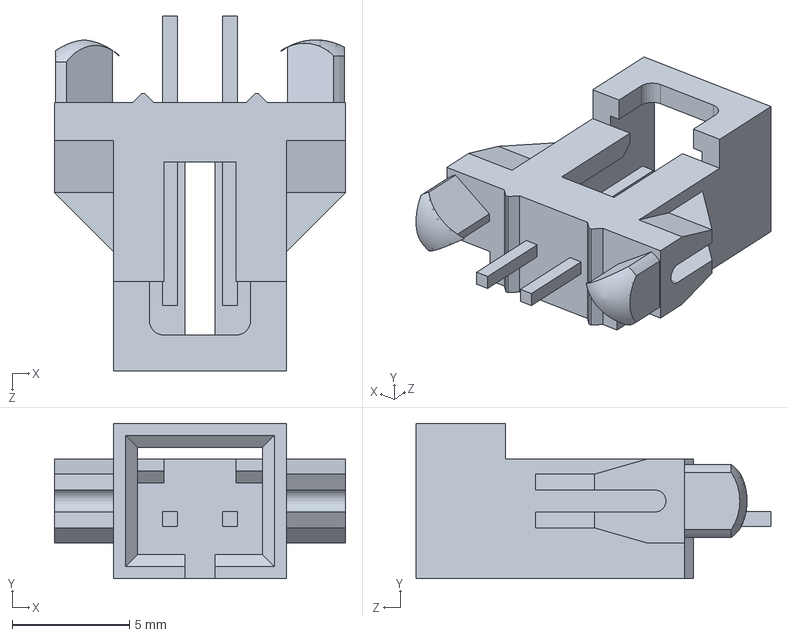
[picture p50: CAD file, 2020-01-03]
2017/StormNet 3X Board/Molex-SL-2P.SLDPRT
12.4 x 6.60 x 15.1 mm
