Stormgears-FRC-5422/StormNet/2017/StormNet 3X Board/arduino nano290313/nano - reg.SLDPRT

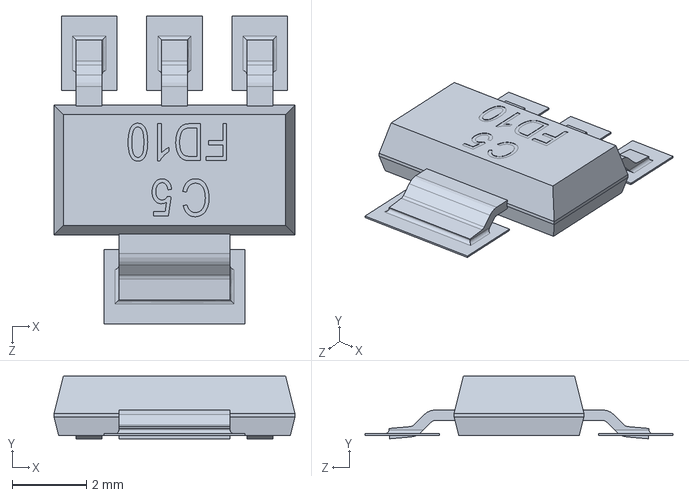
[picture p51: CAD file, 2020-01-03]
2017/StormNet 3X Board/arduino nano290313/nano - reg.SLDPRT
6.50 x 1.69 x 8.30 mm
