Stormgears-FRC-5422/StormNet/2017/StormNet 3X Board/Board.sldprt

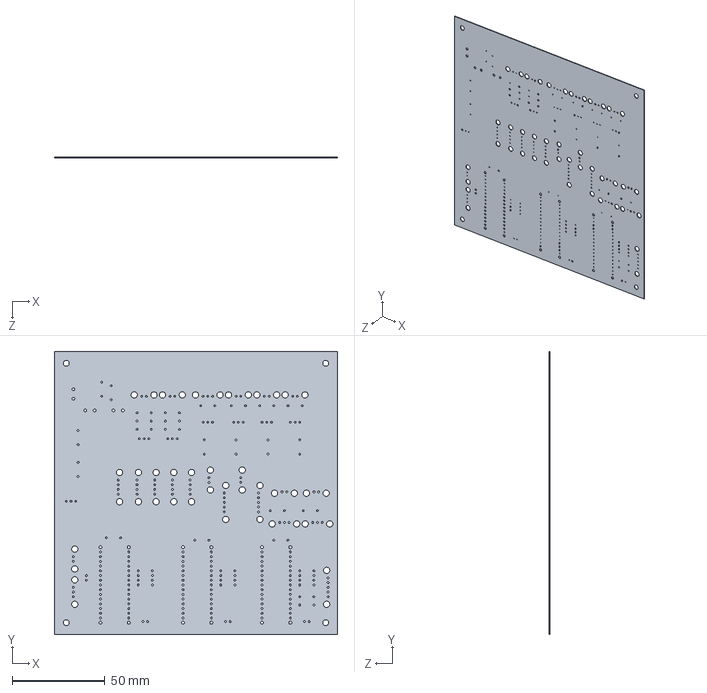
[picture p52: CAD file, 2020-01-03]
2017/StormNet 3X Board/Board.sldprt
152.4 x 152.4 x 0.411 mm
