Stormgears-FRC-5422/StormNet/(list of files, cad)

Other CAD files:
2017/StormNet 3X Board/C22.sldasm
2017/StormNet 3X Board/C19.sldasm
2017/StormNet 3X Board/C24.sldasm
2017/StormNet 3X Board/C16.sldasm
2017/StormNet 3X Board/C21.sldasm
2017/StormNet 3X Board/FET-RL_0.sldasm
2017/StormNet 3X Board/C17.sldasm
2017/StormNet 3X Board/C25.sldasm
2017/StormNet 3X Board/C20.sldasm
2017/StormNet 3X Board/C23.sldasm
2017/StormNet 3X Board/FET-RL_1.sldasm
2017/StormNet 3X Board/C26.sldasm
2017/StormNet 3X Board/arduino nano290313/102 RESISTOR PACK.SLDPRT
2017/StormNet 3X Board/Extruded_2.sldprt
2017/StormNet 3X Board/Extruded.sldprt
2017/StormNet 3X Board/Extruded_3.sldprt
2017/StormNet 3X Board/StormNet PCB-v1.3.step
2017/StormNet 3X Board/Extruded_4.sldprt
2017/StormNet 3X Board/1017092848.sldasm
2017/StormNet 3X Board/1017092976.sldasm
2017/StormNet 3X Board/1017093232.sldasm
2017/StormNet 3X Board/1017093616.sldasm
2017/StormNet 3X Board/705450001.SLDPRT
2017/StormNet 3X Board/705450001.stp
2017/StormNet 3X Board/705450002.stp
2017/StormNet 3X Board/705450003.stp
2017/StormNet 3X Board/705450004.stp
2017/StormNet 3X Board/705450005.stp
2017/StormNet 3X Board/Demo Case/93655A005_MALE-FEM THRDED HEX STANDOFF.SLDPRT
2017/StormNet 3X Board/StormNet PCB-v1.3.SLDASM
