Stormgears-FRC-5422/StormNet/2018/StormNetV2-FinalDocs/StormNet Board/design.pdf

D12 D12 | D11 D11 | D10 D10 | D9 D9 | D8 D8 | D7 D7 | D6 D6 | D5 D5 | D4 D4 | D3 D3 | D2 D2 | RST RST | RX0 RX1 | TX1 TX1
5V RST. | RST. GND | GND*2 A5 | A5 A4 | A4 A3 | A3 A2 | A2 A1 | A1 A0 | A0

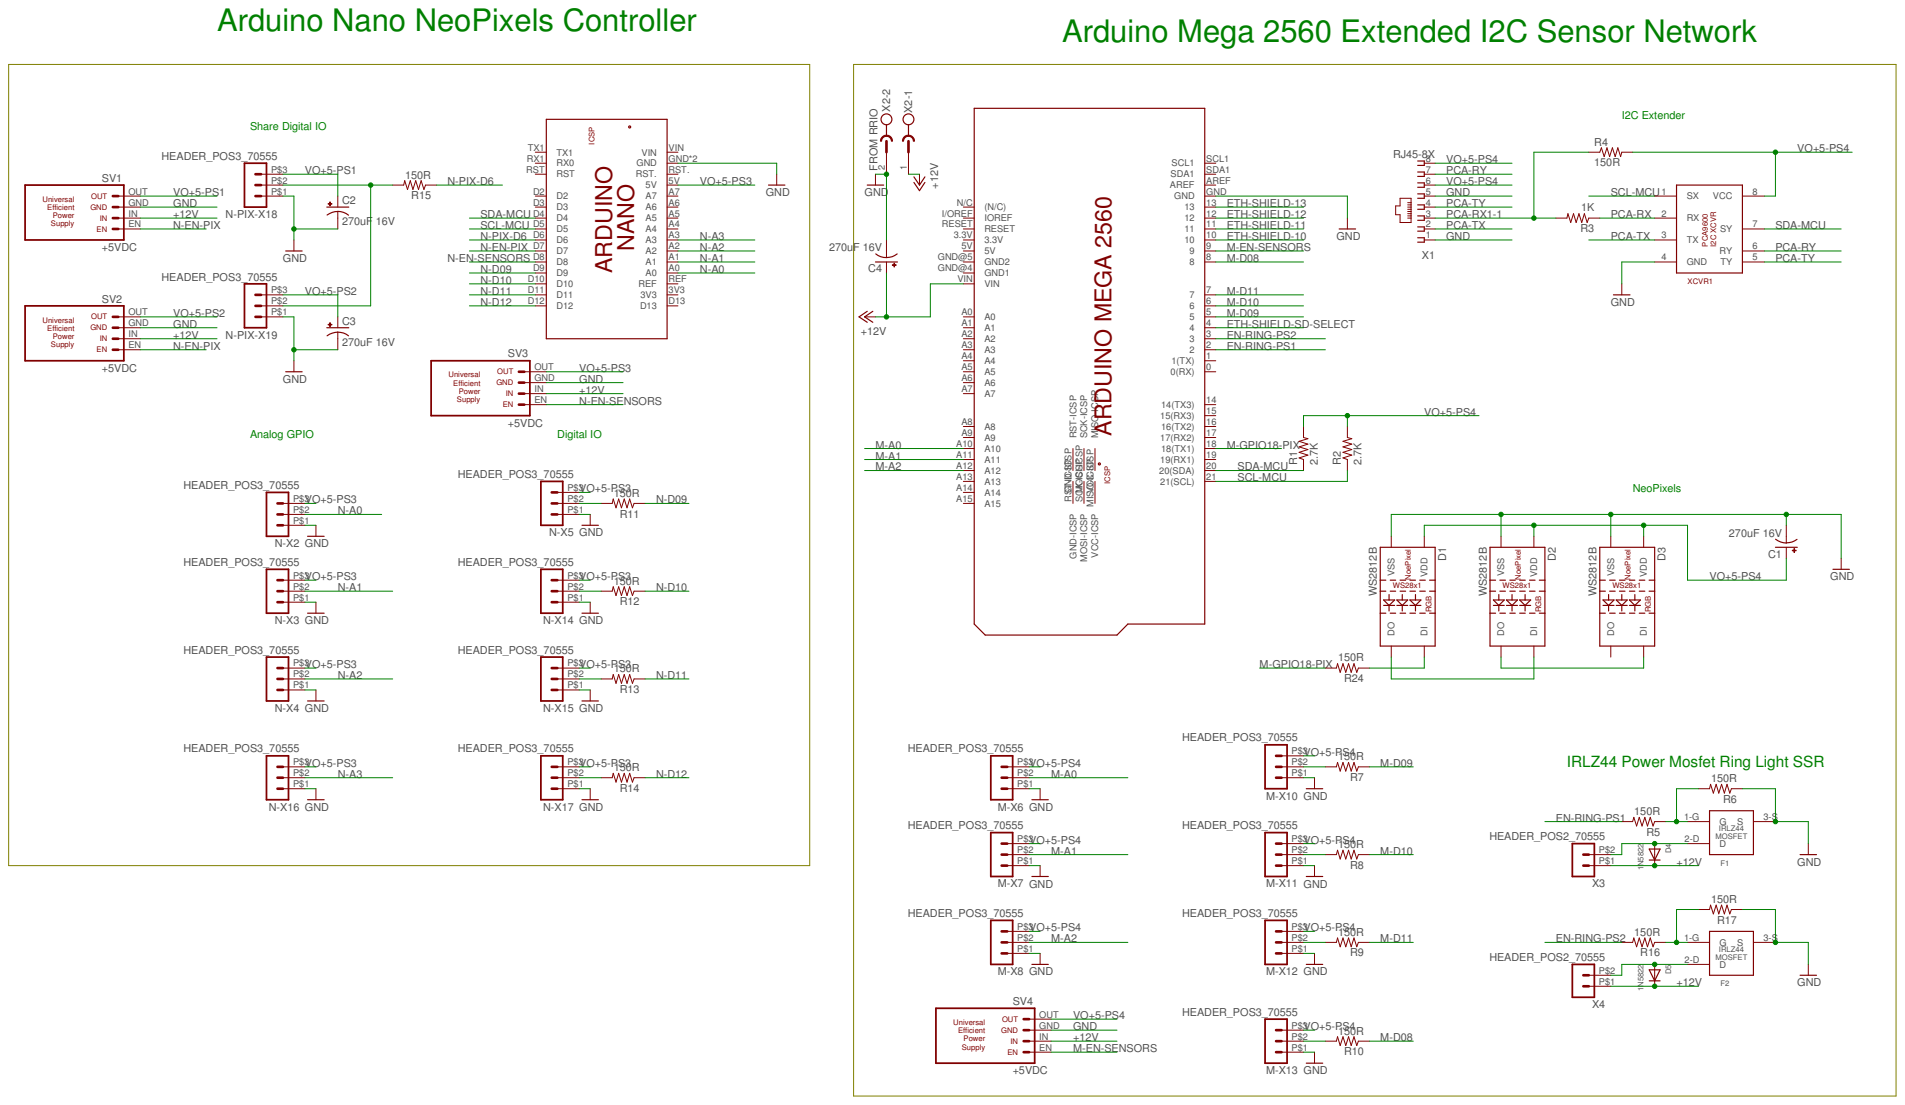
[picture p53: page 1]

Arduino Mega 2560 Extended I2C Sensor Network Arduino Nano NeoPixels Controller

IN GND OUT Universal Efficient Power Supply

SCK-ICSP RST-ICSP RST-ICSP

MISO-ICSP

VCC-ICSP MOSI-ICSP MOSI-ICSP GND-ICSP GND-ICSP

IRLZ44 Power Mosfet Ring Light SSR

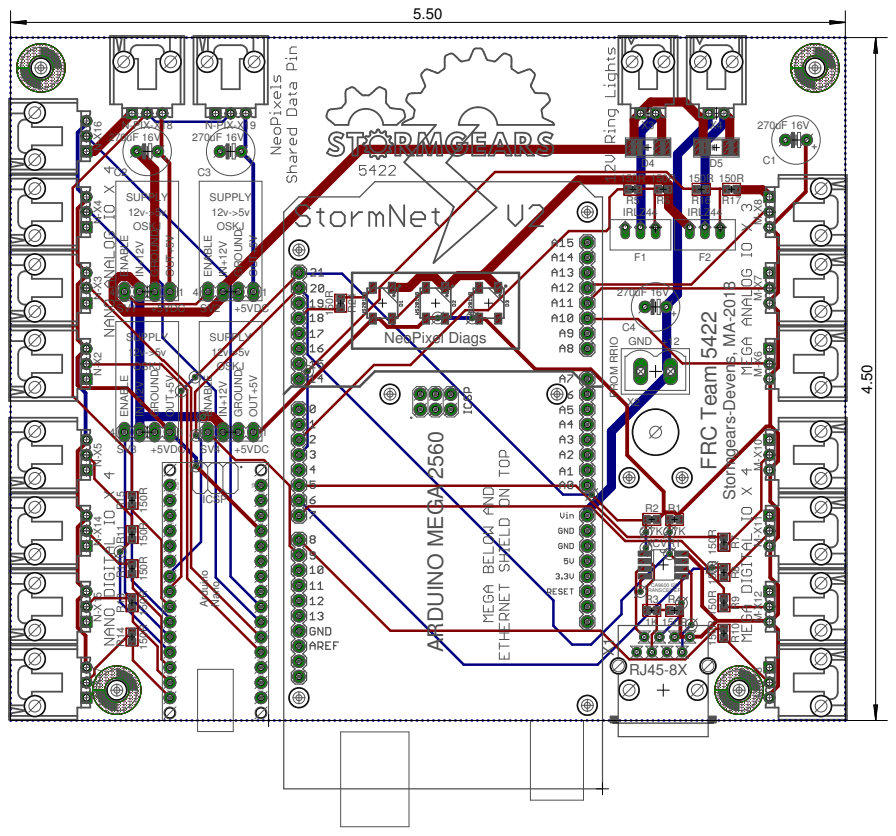
[picture p54: page 2]

FRC Team 5422 Stormgears-Devens, MA-2018 NeoPixel Diags ARDUINO MEGA 2560 ICSP Arduino Nano DORX RST GND D2 D3 D4 D5 D6 D7 D8 D9 D10 D11 D12 GND RST +5VA0A1A2A3A4A5A6A7 AREF 3V3 D13 VIN D1TX GND +12 X3 X4 4 1 OSKJ 12v->5v SUPPLY ENABLE IN+12V GROUND OUT+5V 4 1 OSKJ 12v->5v SUPPLY ENABLE IN+12V GROUND OUT+5V 4 1 OSKJ 12v->5v SUPPLY ENABLE IN+12V GROUND OUT+5V 4 1 OSKJ 12v->5v SUPPLY ENABLE IN+12V GROUND OUT+5V XCVR1 PCA9600 I2C TRANSCEIVER X1 R2 R1 R3 R4 M-X6 M-X7 M-X8 M-X10 M-X11 M-X12 R7 R8 R9 M-X13 R10 N-X2 N-X3 N-X4 N-X5 N-X14 N-X15 R11 R12 R13 N-X16 N-X17 R14 N-PIX-X18 R15 N-PIX-X19 R24 X2 FROM RRIO IRLZ44 F1 R5 R6 D4 IRLZ44 F2 R16 R17 D5 C1 C2 C3 SV1 SV2 SV3 SV4 C4RJ45-8X 2.7K2.7K 1K 150R 150R 150R 150R 150R 150R 150R 150R 150R 150R 150R 150R 150R 150R 150R 270uF 16V 270uF 16V 270uF 16V +5VDC +5VDC +5VDC +5VDC 270uF 16V 5.50 4.50
