Stormgears-FRC-5422/StormNet/2018/StormNetV2-FinalDocs/StormNet Board/StormNet18-v0.1-Schematic.pdf

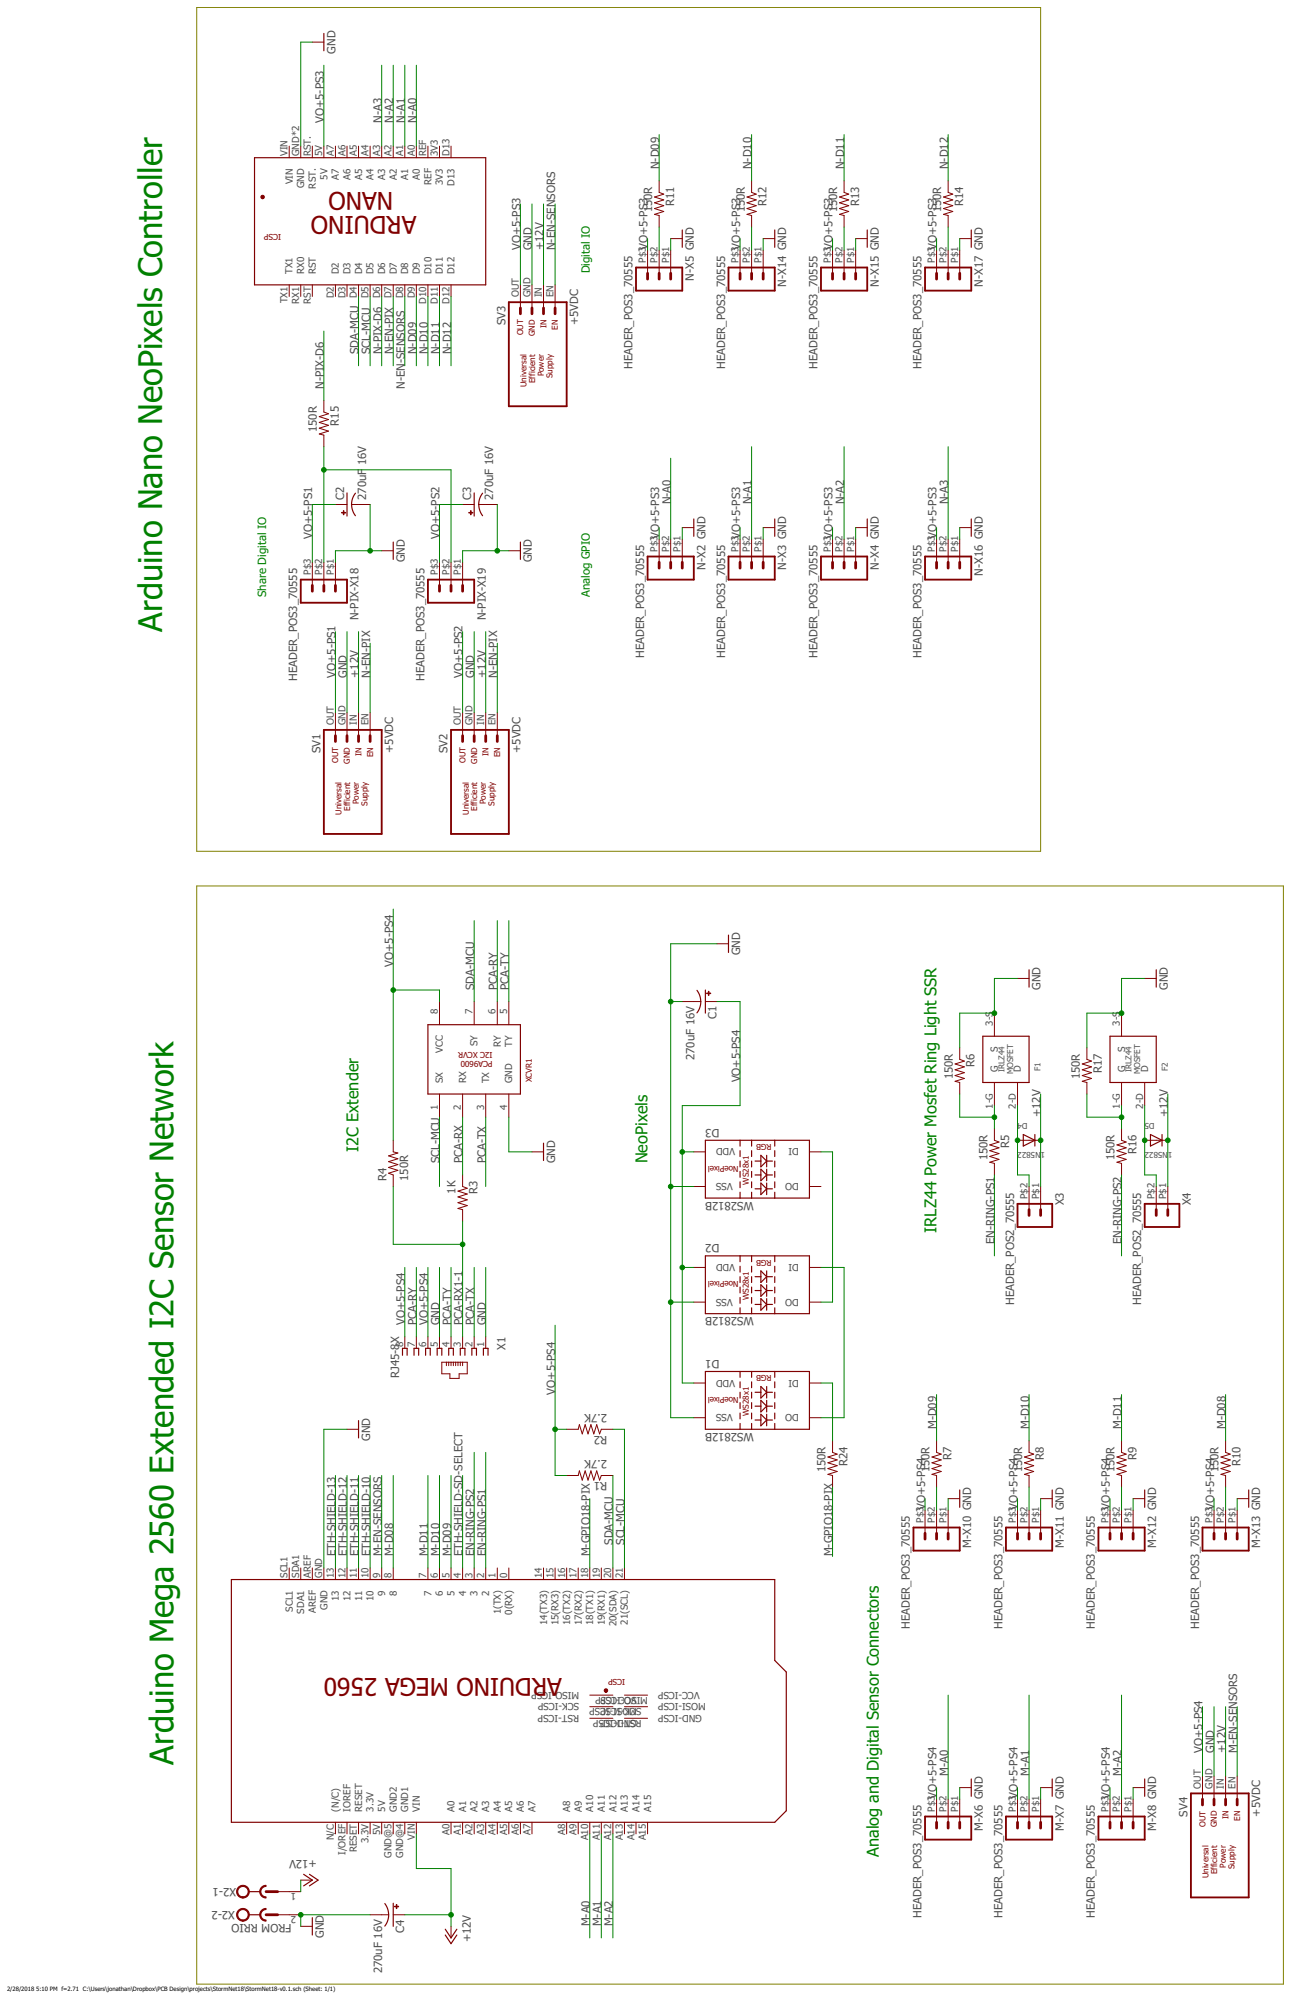
[picture p55: page 1]

2/28/2018 5:10 PM f=2.71 C:\Users\jonathan\Dropbox\PCB Design\projects\StormNet18\StormNet18-v0.1.sch (Sheet: 1/1)
