Stormgears-FRC-5422/StormNet/2018/StormNetV2-FinalDocs/StormNet LiDAR Node/design.pdf

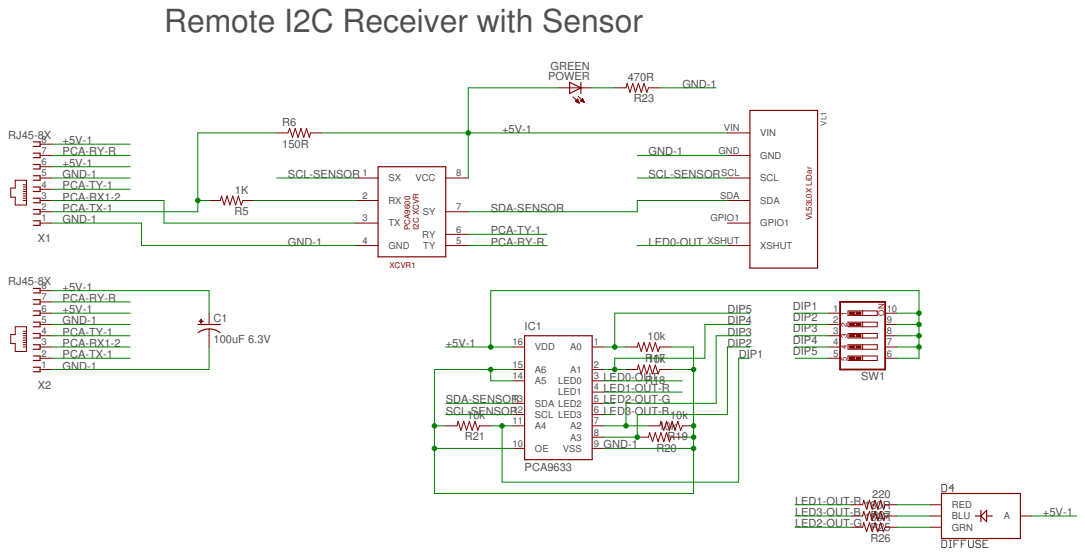
[picture p56: page 1]

2.50

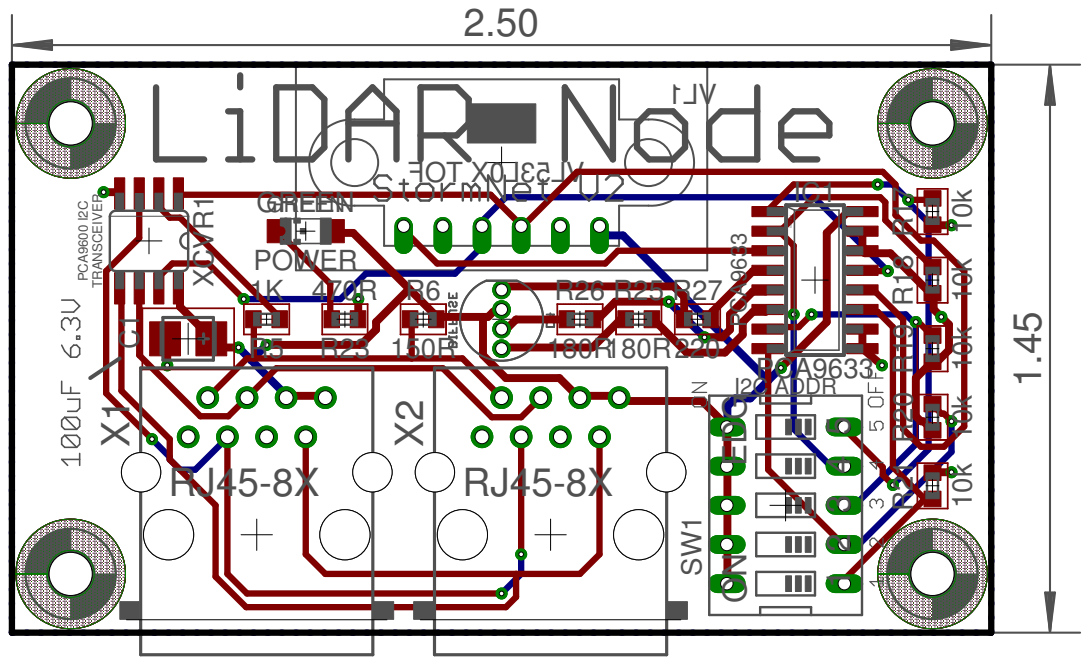
[picture p57: page 2]
SOT109-1 1O; GREEN; I2C ADDR; EIV; POWER; PCA9633
