Stormgears-FRC-5422/StormNet/2018/StormNetV2-FinalDocs/StormNet Board/StormNet18-v0.1-Bottom-withPour.pdf

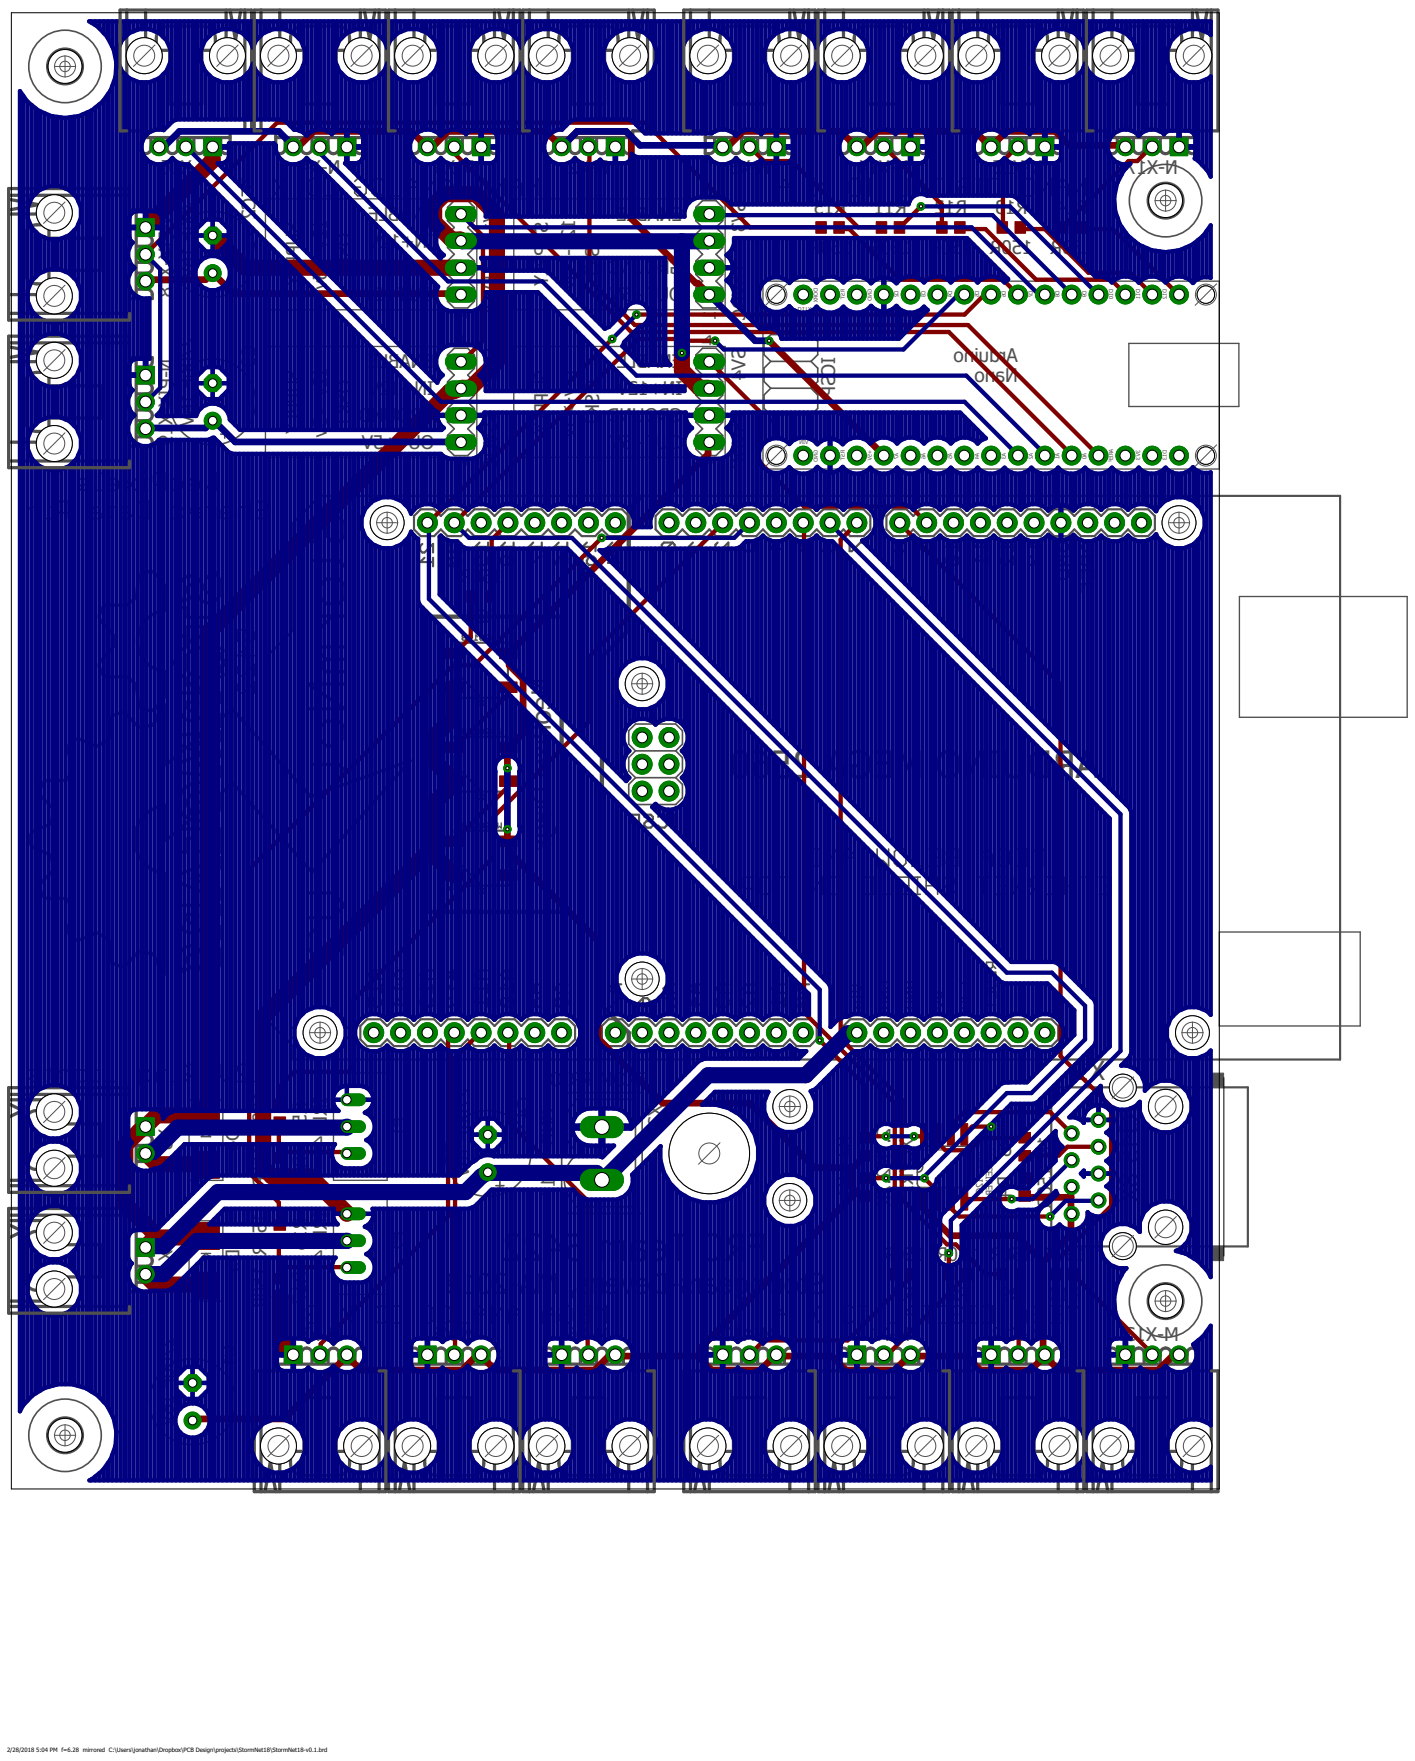
[picture p58: page 1]

2/28/2018 5:04 PM f=6.28 mirrored C:\Users\jonathan\Dropbox\PCB Design\projects\StormNet18\StormNet18-v0.1.brd
