Stormgears-FRC-5422/StormNet/2018/StormNetV2-FinalDocs/StormNet Board/StormNet18-v0.1-Bottom.pdf

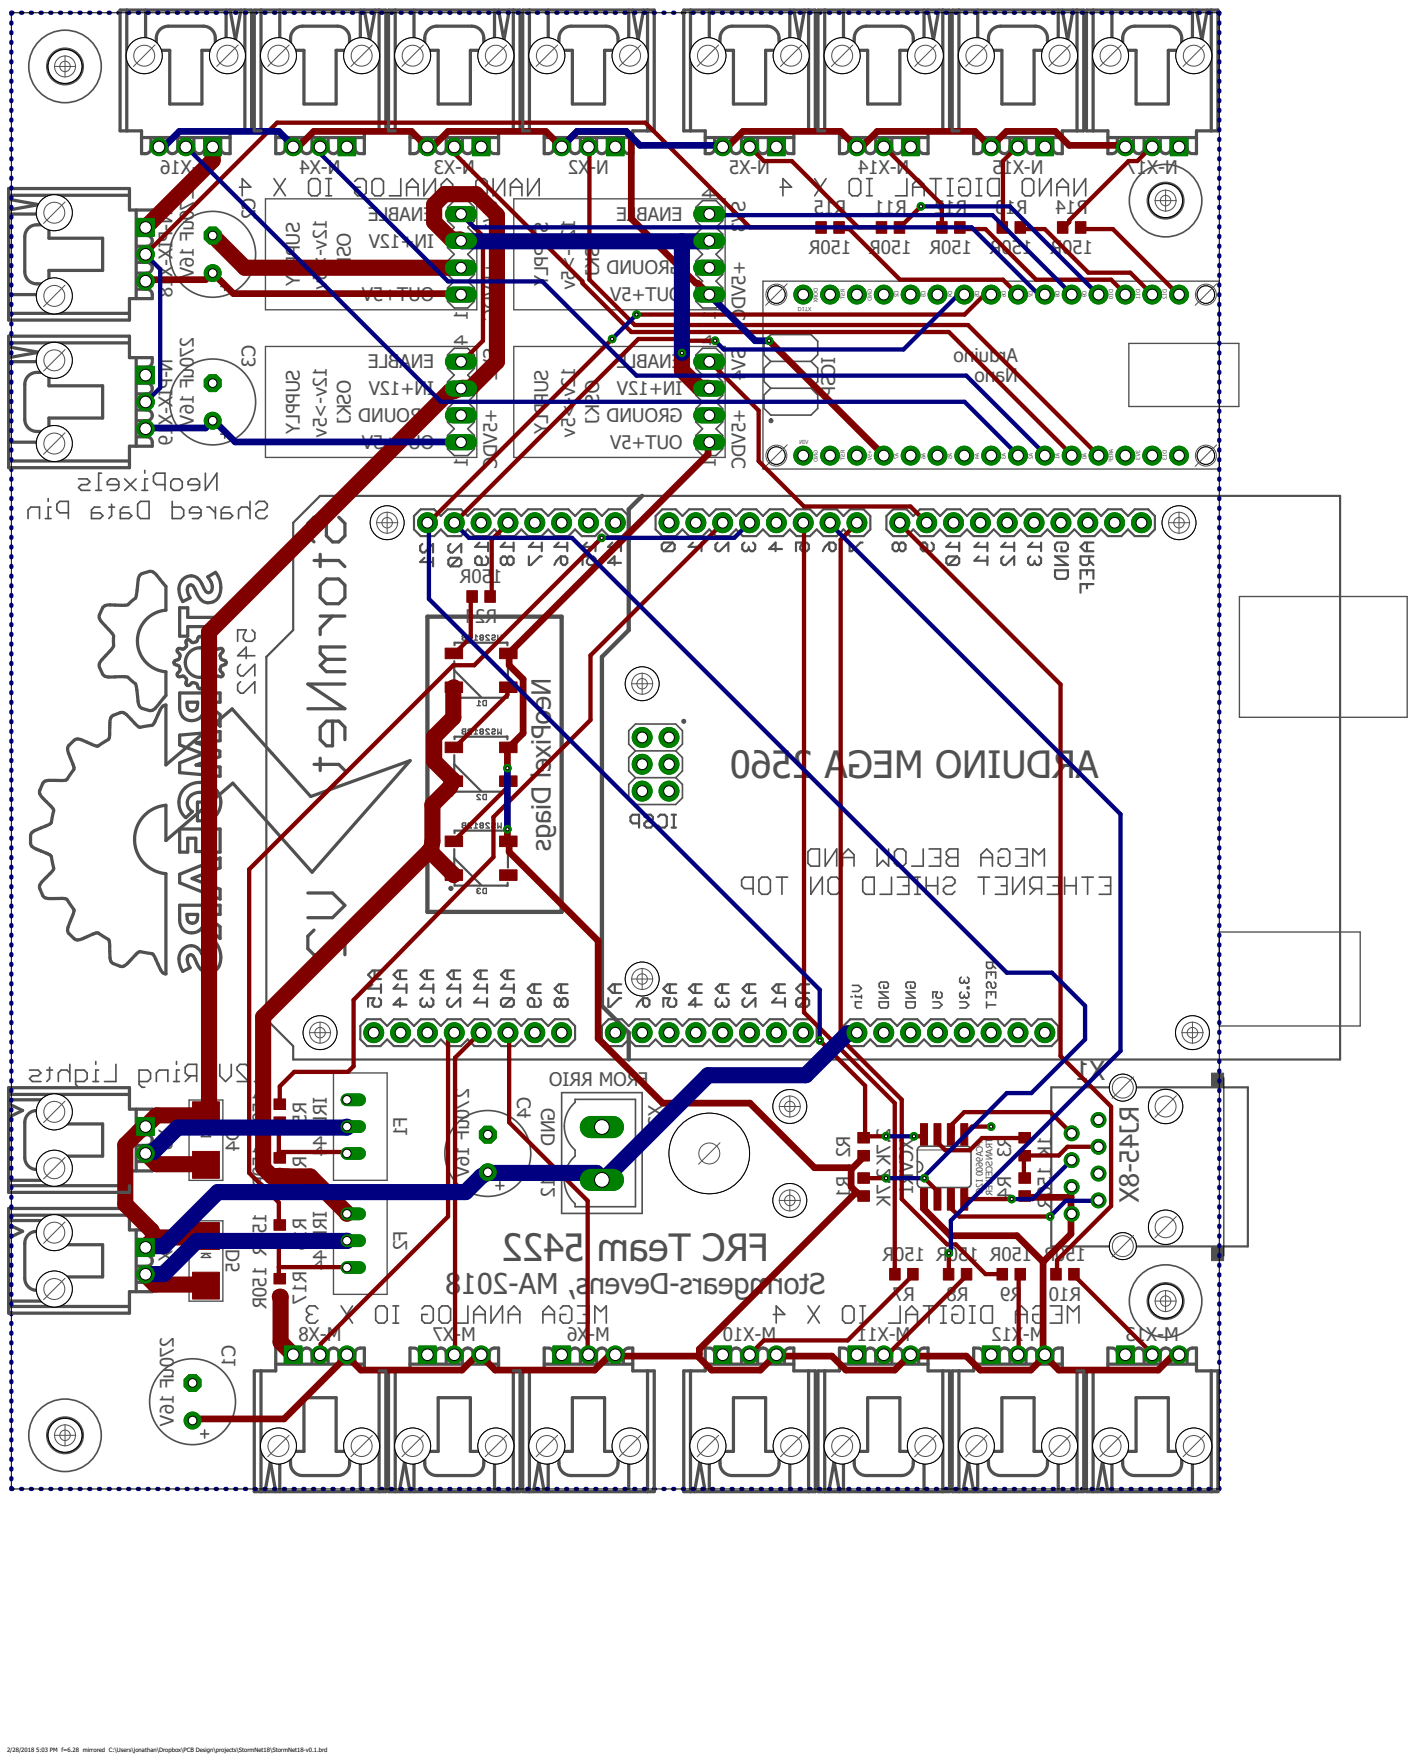
[picture p59: page 1]

2/28/2018 5:03 PM f=6.28 mirrored C:\Users\jonathan\Dropbox\PCB Design\projects\StormNet18\StormNet18-v0.1.brd
