Stormgears-FRC-5422/StormNet/2018/StormNetV2-FinalDocs/StormNet Board/StormNet18-v0.1-Top-WithPour.pdf

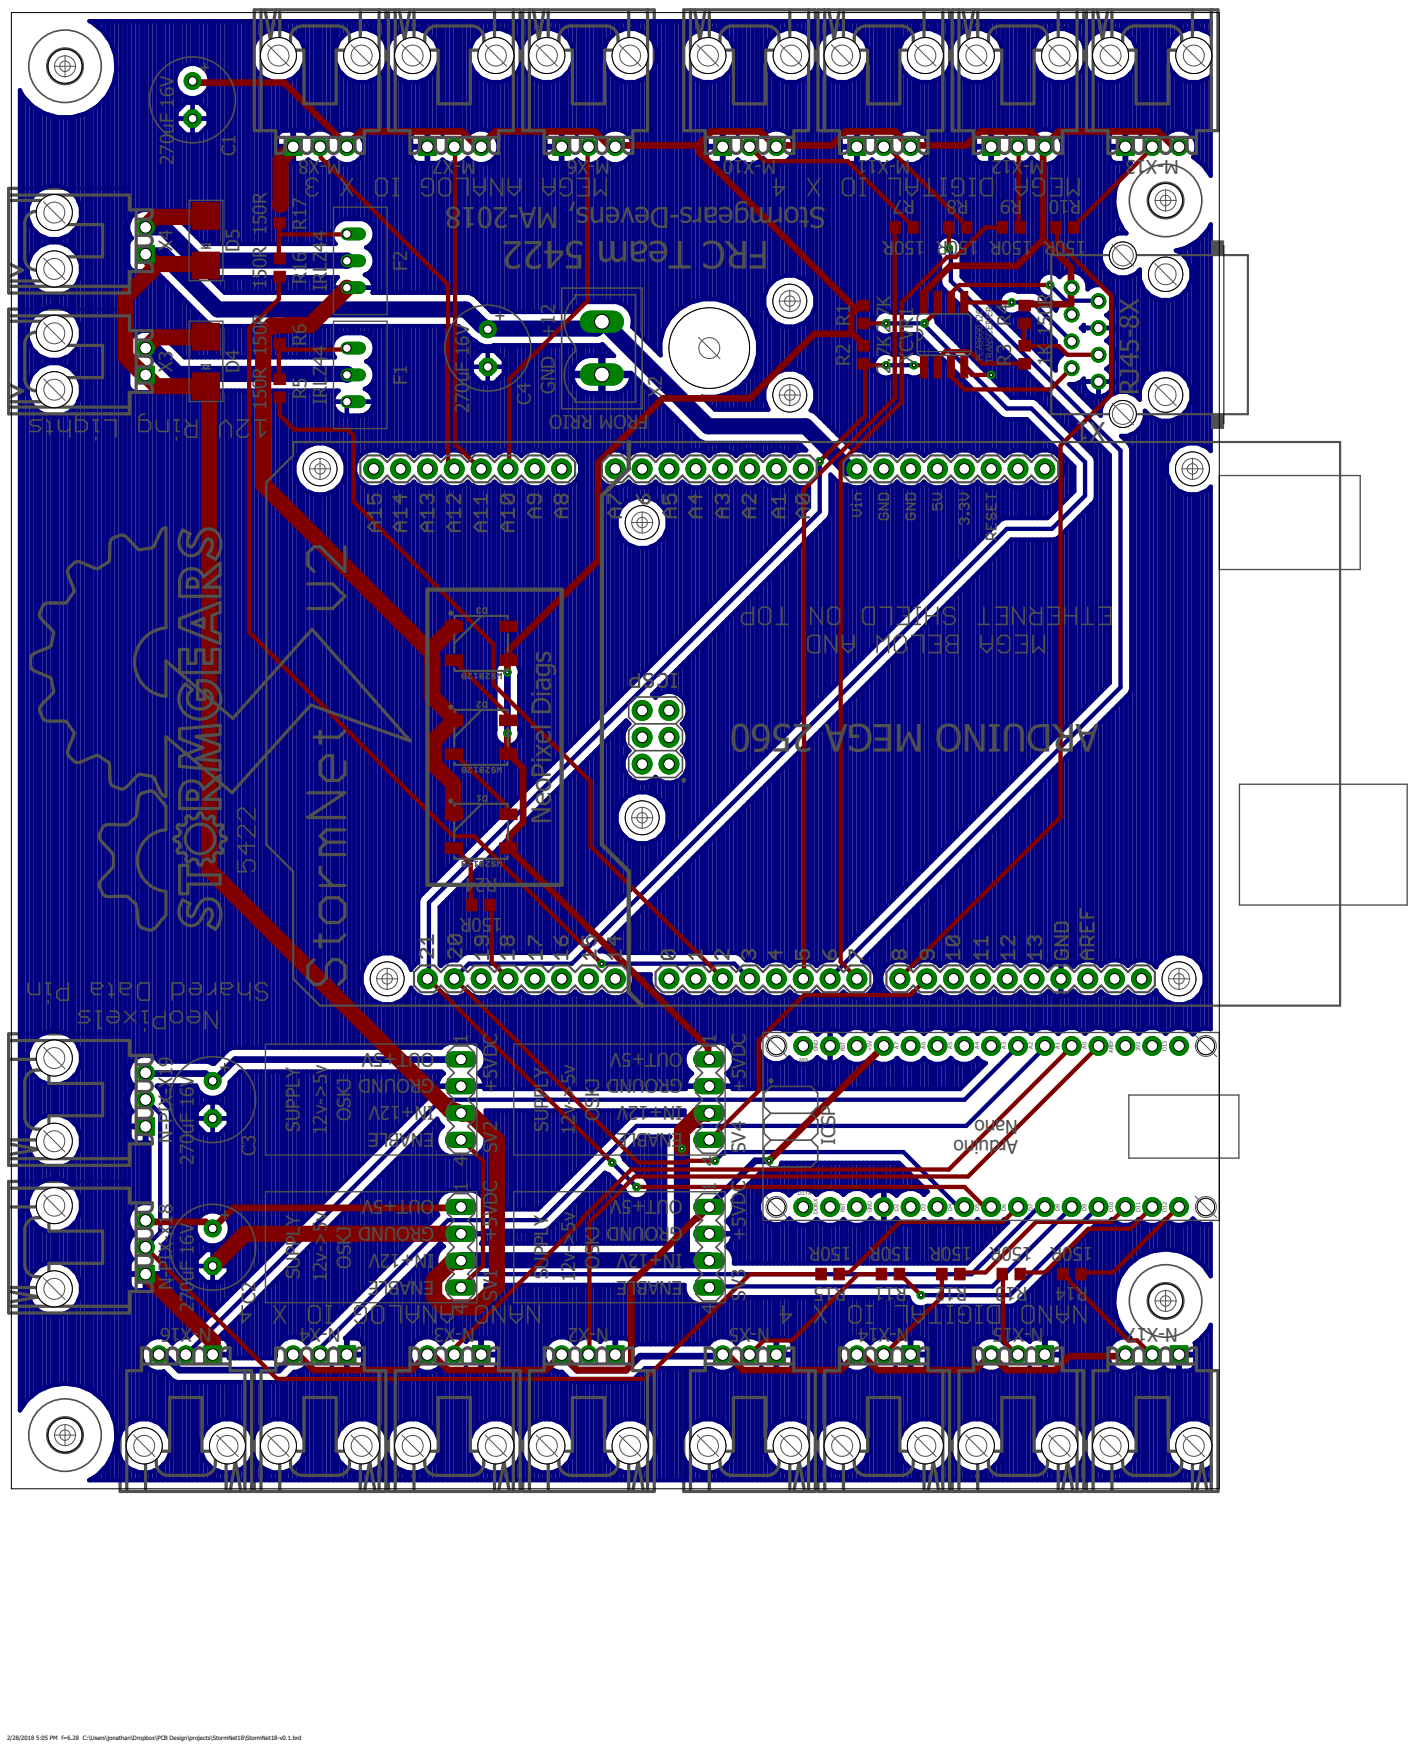
[picture p60: page 1]

2/28/2018 5:05 PM f=6.28 C:\Users\jonathan\Dropbox\PCB Design\projects\StormNet18\StormNet18-v0.1.brd
