Stormgears-FRC-5422/StormNet/2017/StormNet 3X Board/Assembly Guide.pdf

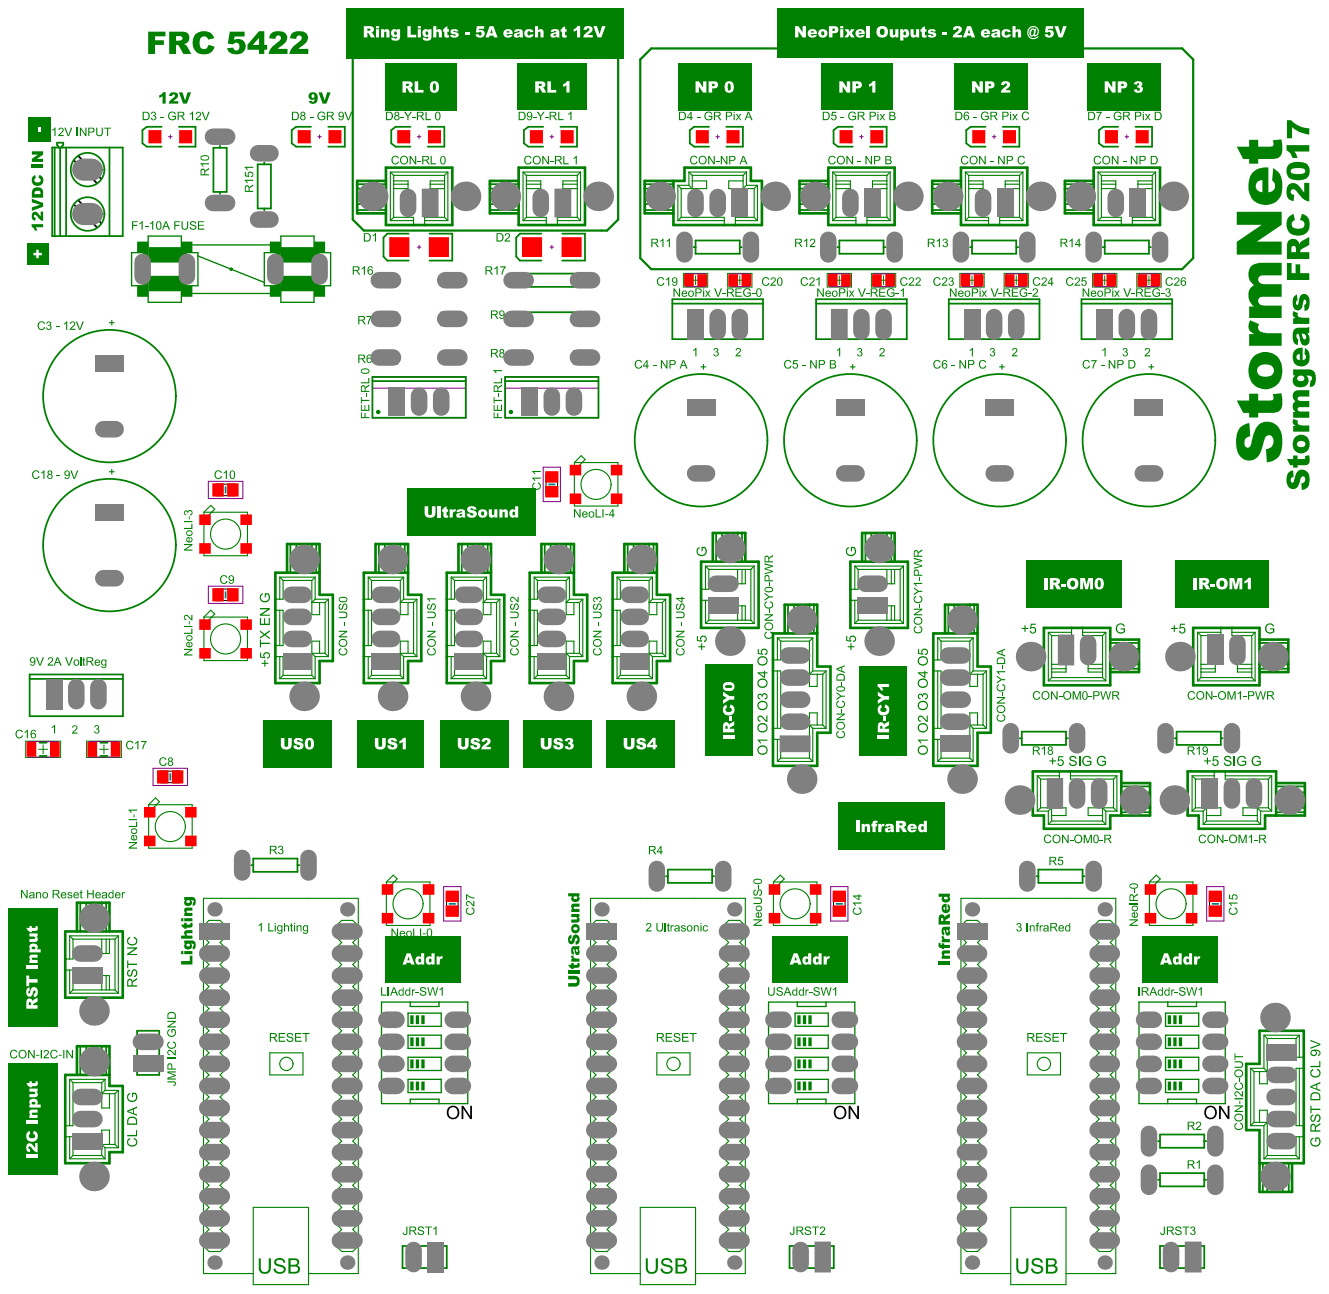
[picture p61: page 1]
