Stormgears-FRC-5422/StormNet/2017/StormNet 3X Board/StormNet Board Project/Assembly Drawing.pdf

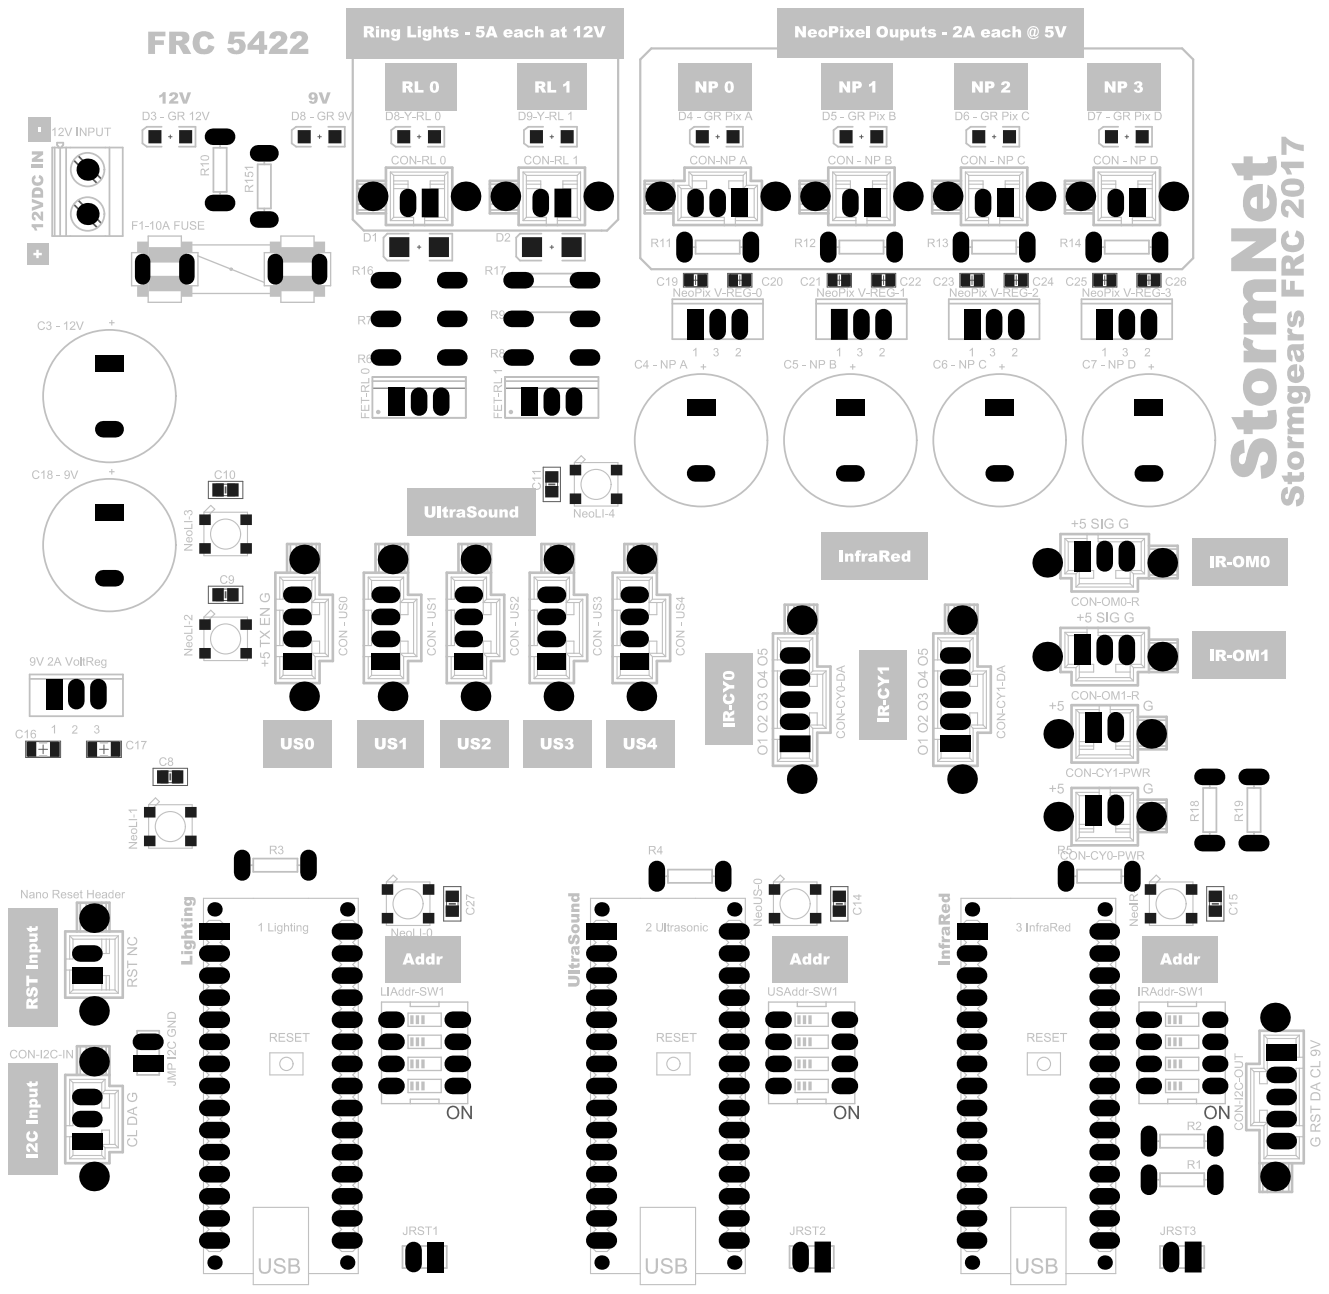
[picture p62: page 1]
