Stormgears-FRC-5422/StormNet/2018/StormNetV2-FinalDocs/StormNet LiDAR Node/StormNet18-Remote-v0.1-Schematic.pdf

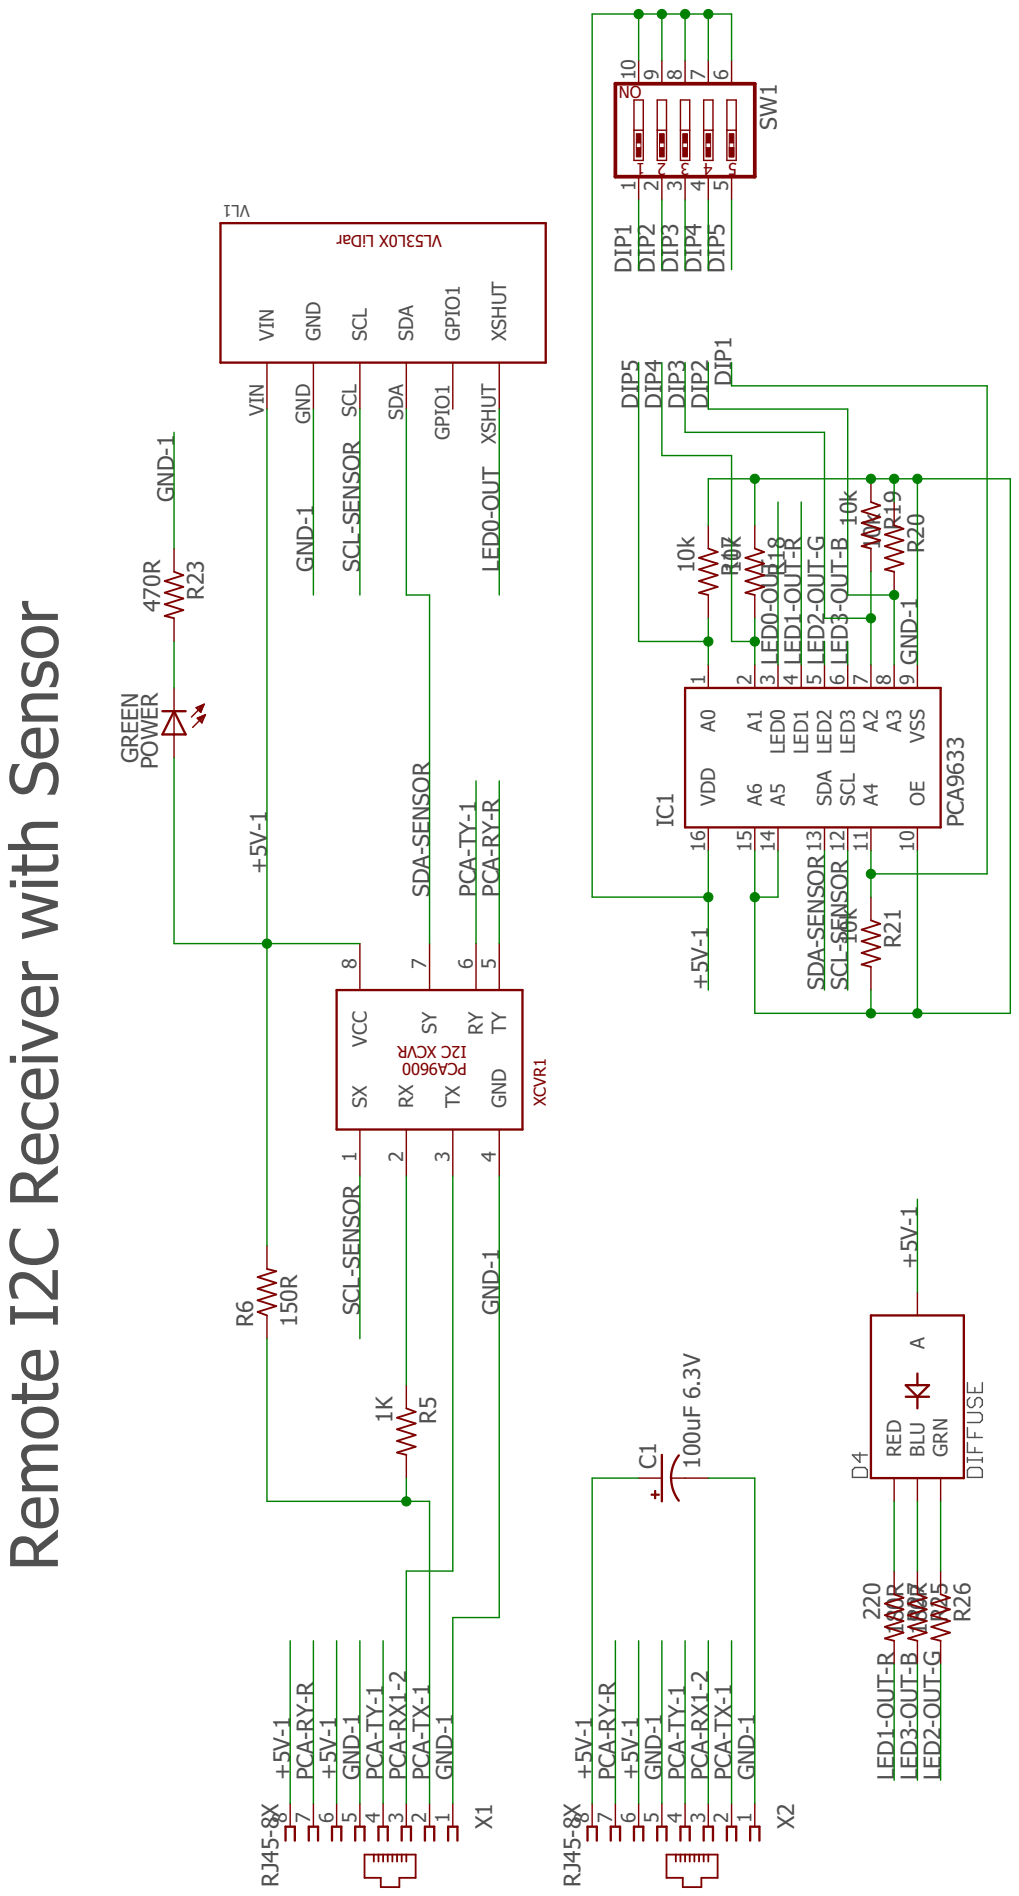
[picture p63: page 1]
