Stormgears-FRC-5422/StormNet/2017/StormNet 3X Board/StormNet Board Project/Outputs/Schematic.pdf

NeoPixels on Lighting Controller P$1 | P$2 | P$3 | P$4

# StormNet 2017

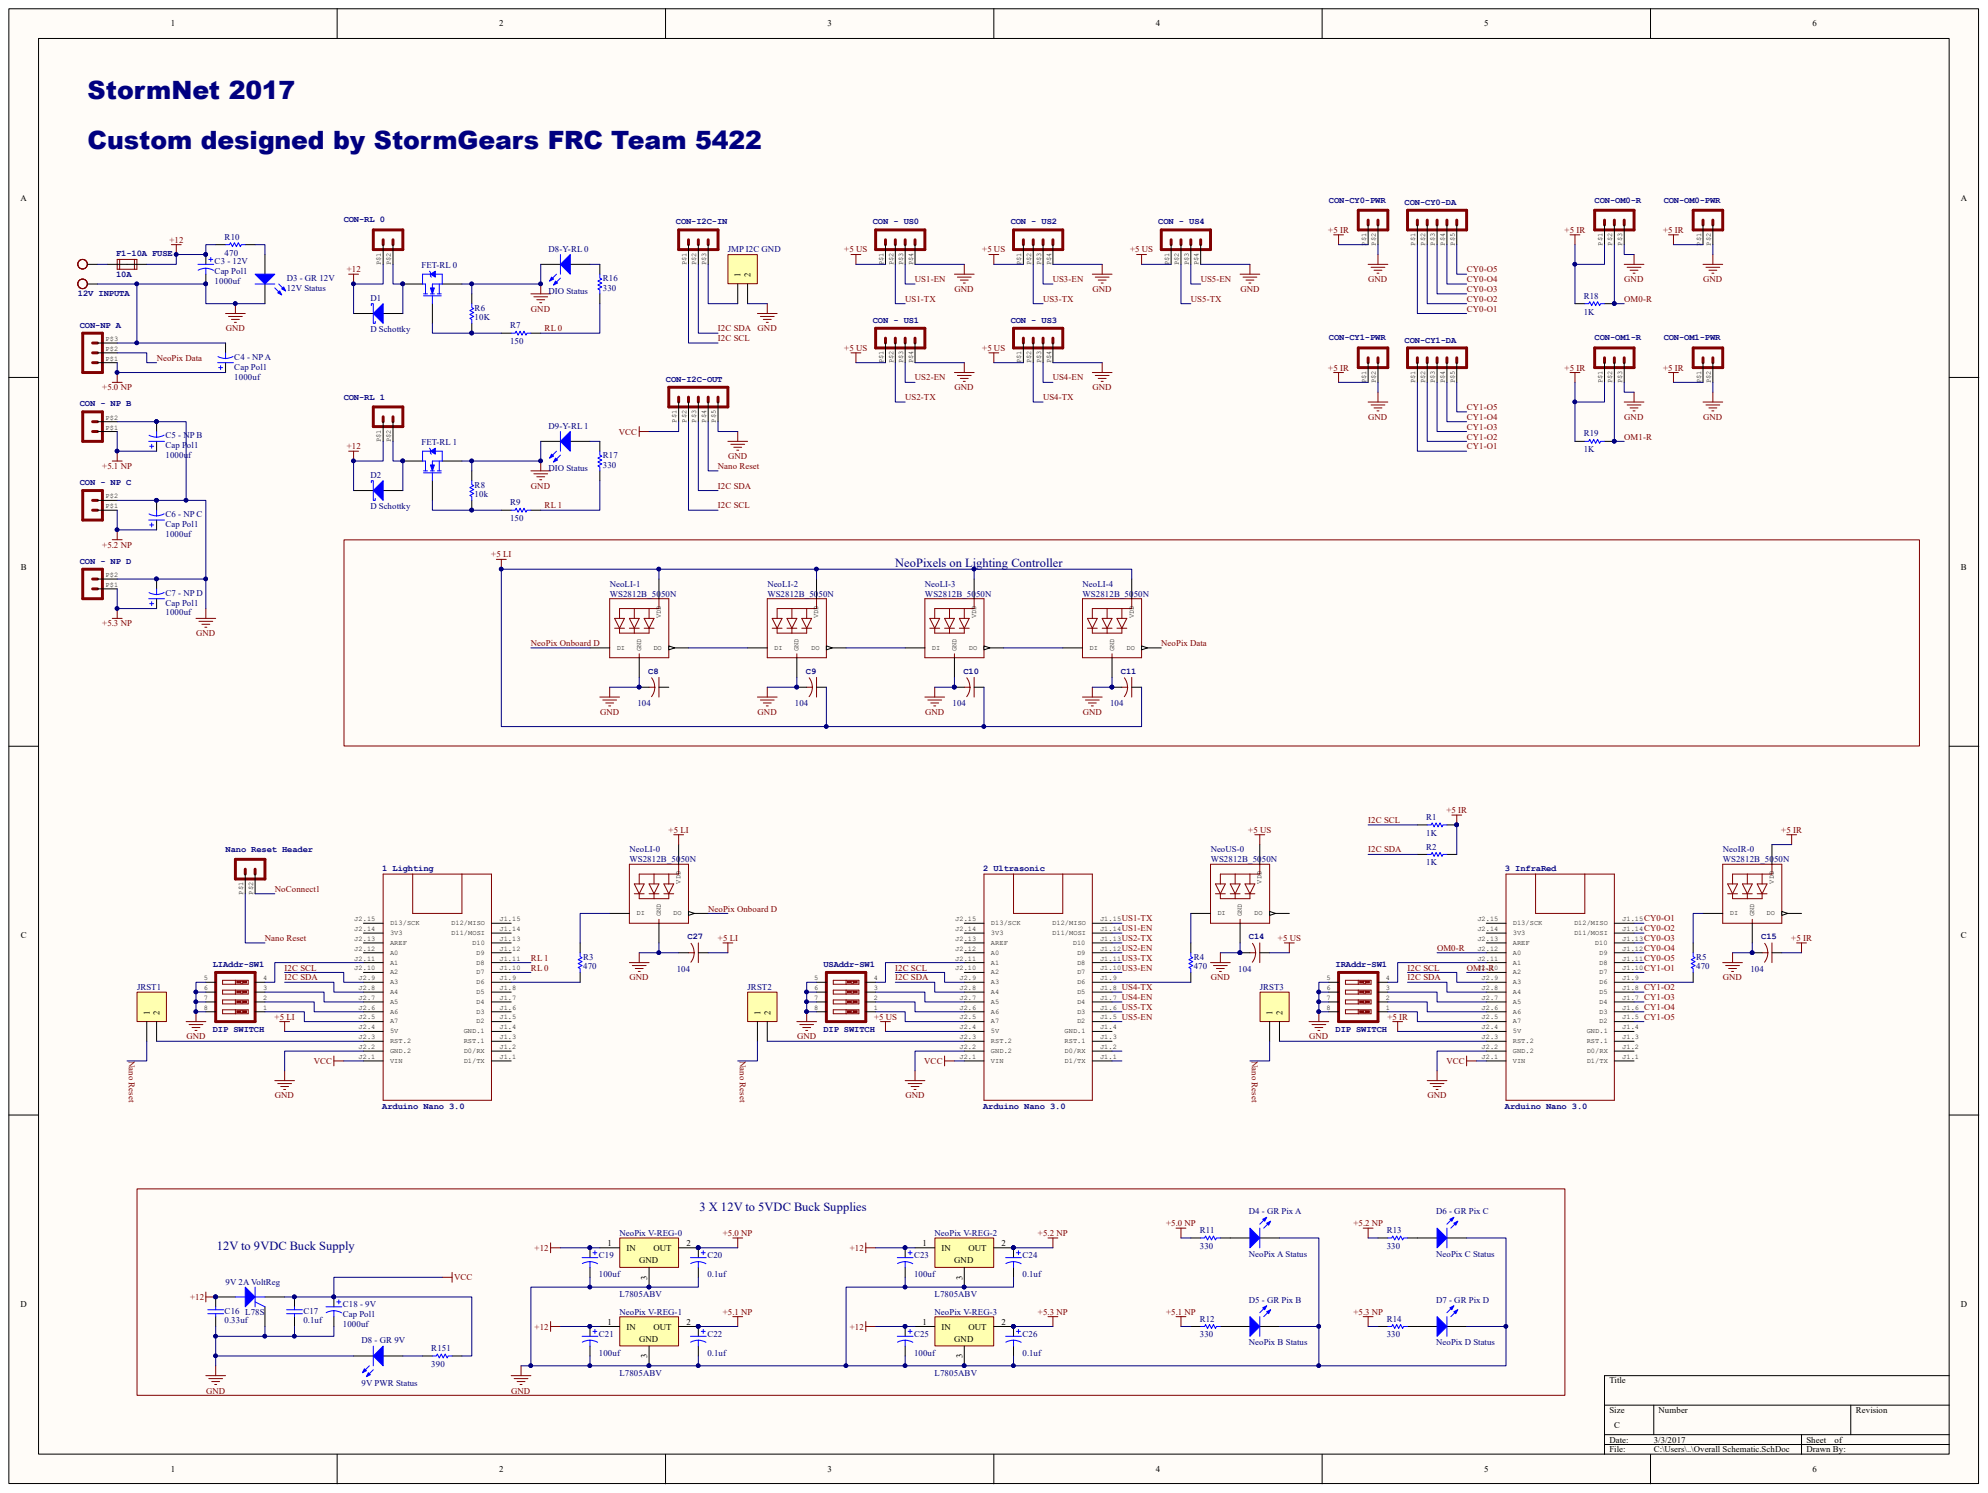
[picture p64: page 1]

Custom designed by StormGears FRC Team 5422
