Stormgears-FRC-5422/StormNet/2017/StormNet 3X Board/StormNet Board Project/Outputs/StormNet Assembly Drawing v1.3.pdf

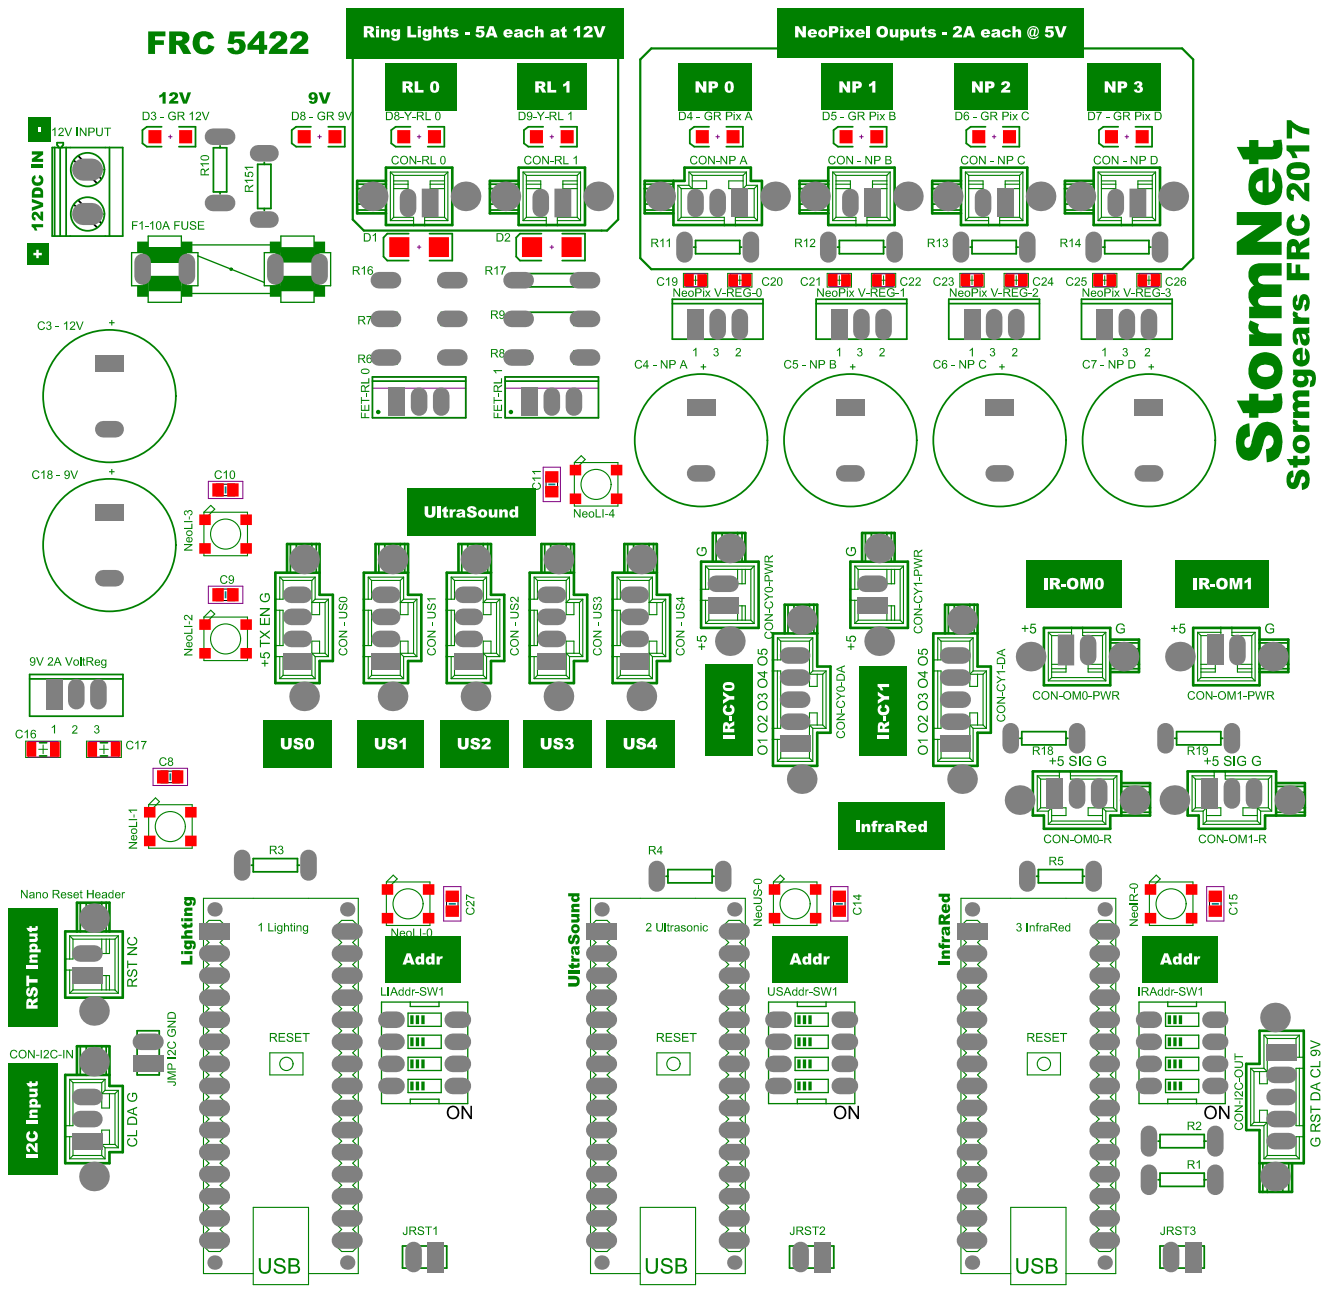
[picture p65: page 1]
