Stormgears-FRC-5422/StormNet/2018/StormNetV2-FinalDocs/StormNet LiDAR Node/StormNet18-Remote-v0.1-Bottom.pdf

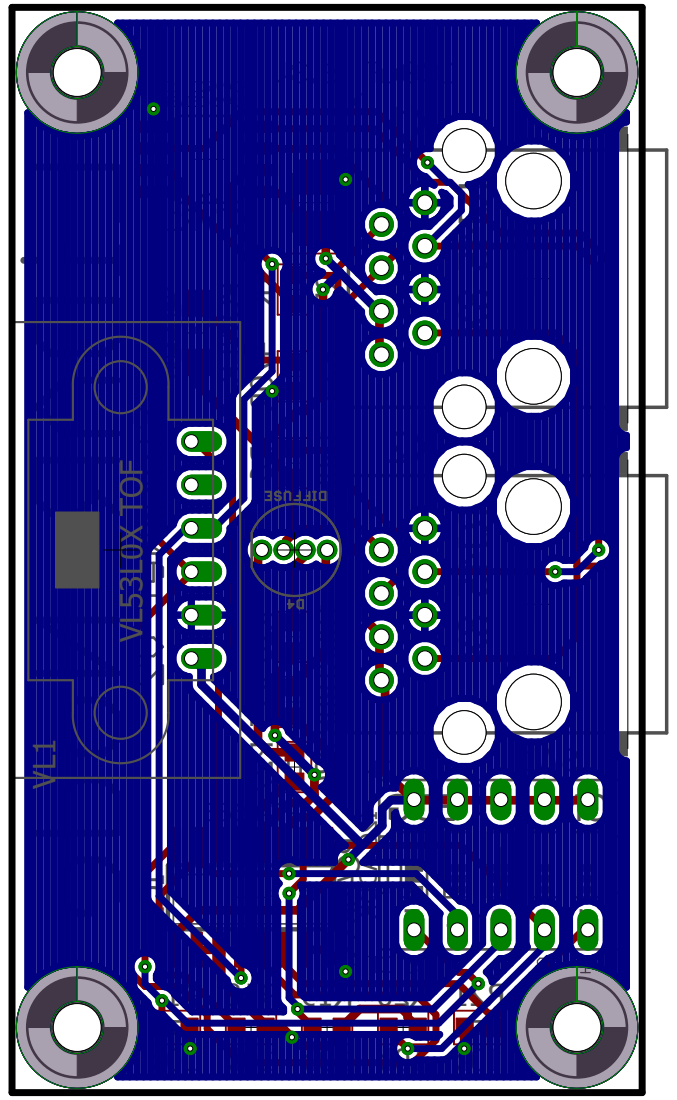
[picture p66: page 1]
