Stormgears-FRC-5422/StormNet/2017/StormNet 3X Board/StormNet Board Project/Outputs/PCB.pdf

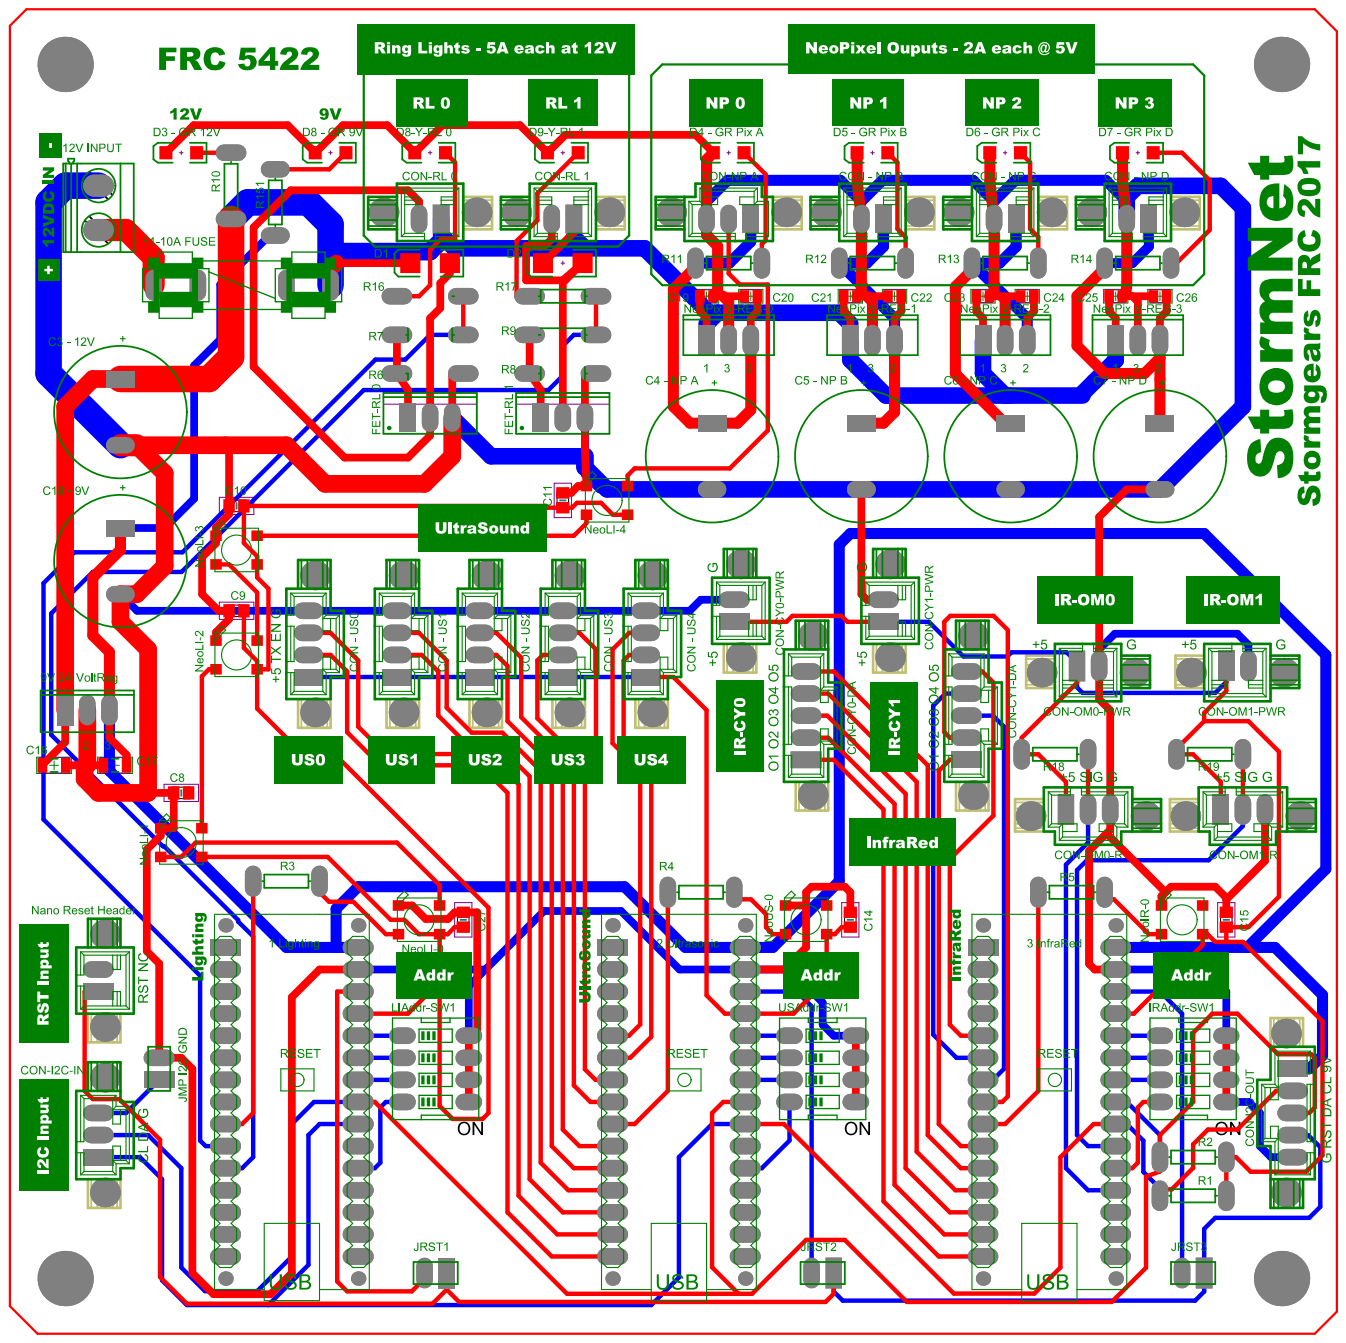
[picture p68: page 1]
