Stormgears-FRC-5422/StormNet/(list of files, drawings)

Other design files:
2017/Schematics and PCBs/StormNet_Lights.SchDoc
2017/StormNet 3X Board/Scripts/Delphiscript Scripts/PCB/PadViaExamples.PcbDoc
2017/StormNet 3X Board/Scripts/Delphiscript Scripts/PCB/PCB Iterators/Polygons.PcbDoc
2017/StormNet 3X Board/Scripts/Delphiscript Scripts/SCH/Connectivity/NetInfoPrj.PrjPCB
2017/StormNet 3X Board/StormNet Board Project/adafruit.PCBLIB
2017/StormNet 3X Board/StormNet Board Project/adafruit.SCHLIB
2017/StormNet 3X Board/StormNet Board Project/con-molex-c-grid-sl.PCBLIB
2017/StormNet 3X Board/StormNet Board Project/con-molex-c-grid-sl.SCHLIB
2017/StormNet 3X Board/StormNet Board Project/con-phoenix-508.PCBLIB
2017/StormNet 3X Board/StormNet Board Project/con-phoenix-508.SCHLIB
2017/StormNet 3X Board/StormNet Board Project/con-tycoelectronics.PCBLIB
2017/StormNet 3X Board/StormNet Board Project/con-tycoelectronics.SCHLIB
2017/StormNet 3X Board/StormNet Board Project/Overall Schematic.SchDoc
2017/StormNet 3X Board/StormNet Board Project/ptc-littlefuse.PCBLIB
2017/StormNet 3X Board/StormNet Board Project/ptc-littlefuse.SCHLIB
2017/StormNet 3X Board/StormNet Board Project/special.PCBLIB
2017/StormNet 3X Board/StormNet Board Project/special.SCHLIB
2017/StormNet 3X Board/StormNet Board Project/StormNet Board Project.PrjPcb
2018/StormNet18-v1/adafruit.PCBLIB
2018/StormNet18-v1/adafruit.SCHLIB
2018/StormNet18-v1/Overview.SchDoc
2018/StormNet18-v1/StormNet18-v1.PrjPcb
