Stormgears-FRC-5422/StormNet/2018/StormNetV2-FinalDocs/StormNet LiDAR Node/Eagle7.7.0 CAD files/StormNet18-Remote-v0.1.brd

## EAGLE design 2018/StormNetV2-FinalDocs/StormNet LiDAR Node/Eagle7.7.0 CAD files/StormNet18-Remote-v0.1.brd (2020-01-03)

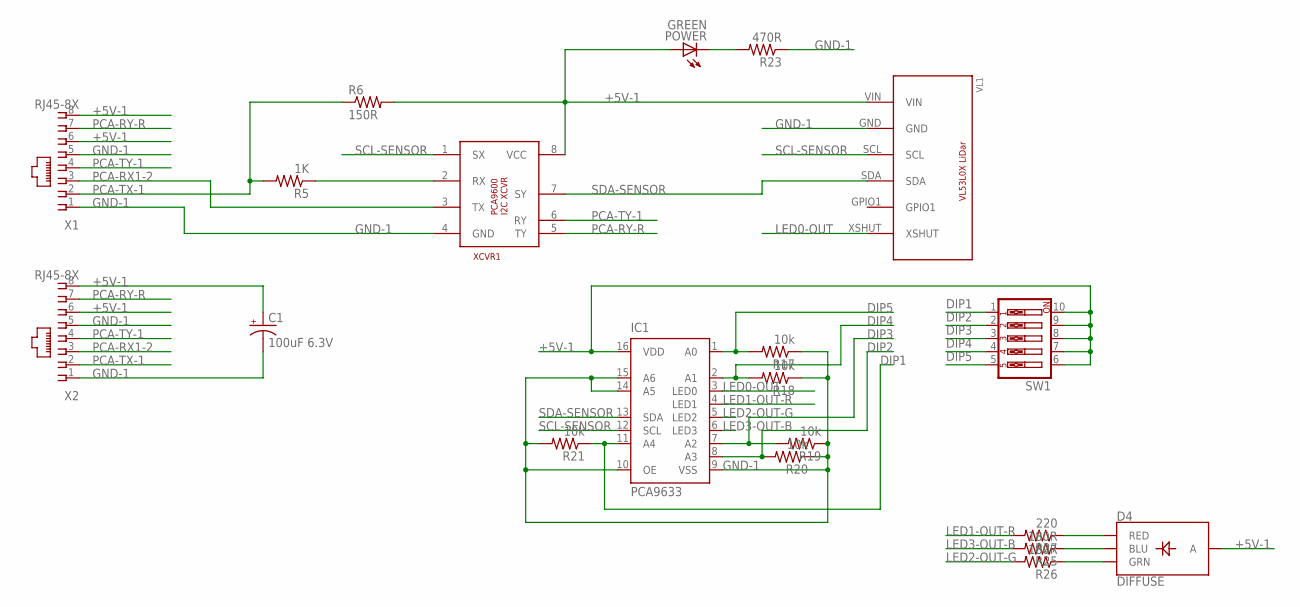
[picture p70: schematic StormNet18-Remote-v0.1.sch]

Parts:
C1: 100uF 6.3V; CT3528
D4: DIFFUSE; LED-RGB-THRU
IC1: PCA9633; SO16
POWER: GREEN; CHIPLED_1206
R5: 1K; R0603
R6: 150R; R0603
R17, R18, R19, R20, R21: 10k; R0603
R23: 470R; R0603
R25, R26: 180R; R0603
R27: 220; R0603
SW1: SW_DIP-5; EDG-05
VL1: VL53L0X-GREEN
X1, X2: RJ45-8X; RJ45-NO-SHIELD
XCVR1: PCA9600DSO8; SO08

Connections:
+5V-1: C1.+, D4.2 (A), IC1.16 (VDD), POWER.A, R6.2, SW1.6, SW1.7, SW1.8, SW1.9, SW1.10, VL1.VIN, X1.6, X1.8, X2.6, X2.8, XCVR1.8 (VCC)
BLUE: D4.4 (BLU), R25.1
DIP1: IC1.11 (A4), R21.1, SW1.1
DIP2: IC1.8 (A3), R20.2, SW1.2
DIP3: IC1.7 (A2), R19.2, SW1.3
DIP4: IC1.2 (A1), R18.2, SW1.4
DIP5: IC1.1 (A0), R17.2, SW1.5
GND-1: C1.-, IC1.9 (VSS), IC1.10 (OE), IC1.14 (A5), IC1.15 (A6), R17.1, R18.1, R19.1, R20.1, R21.2, R23.1, VL1.GND, X1.1, X1.5, X2.1, X2.5, XCVR1.4 (GND)
GREEN: D4.3 (GRN), R26.1
LED0-OUT: IC1.3 (LED0), VL1.XSHUT
LED1-OUT-R: IC1.4 (LED1), R27.2
LED2-OUT-G: IC1.5 (LED2), R26.2
LED3-OUT-B: IC1.6 (LED3), R25.2
unnamed: R5.1, XCVR1.2 (RX)
unnamed: POWER.C, R23.2
PCA-RX1-2: X1.3, X2.3, XCVR1.3 (TX)
PCA-RY-R: X1.7, X2.7, XCVR1.5 (TY)
PCA-TX-1: R5.2, R6.1, X1.2, X2.2
PCA-TY-1: X1.4, X2.4, XCVR1.6 (RY)
RED: D4.1 (RED), R27.1
SCL-SENSOR: IC1.12 (SCL), VL1.SCL, XCVR1.1 (SX)
SDA-SENSOR: IC1.13 (SDA), VL1.SDA, XCVR1.7 (SY)

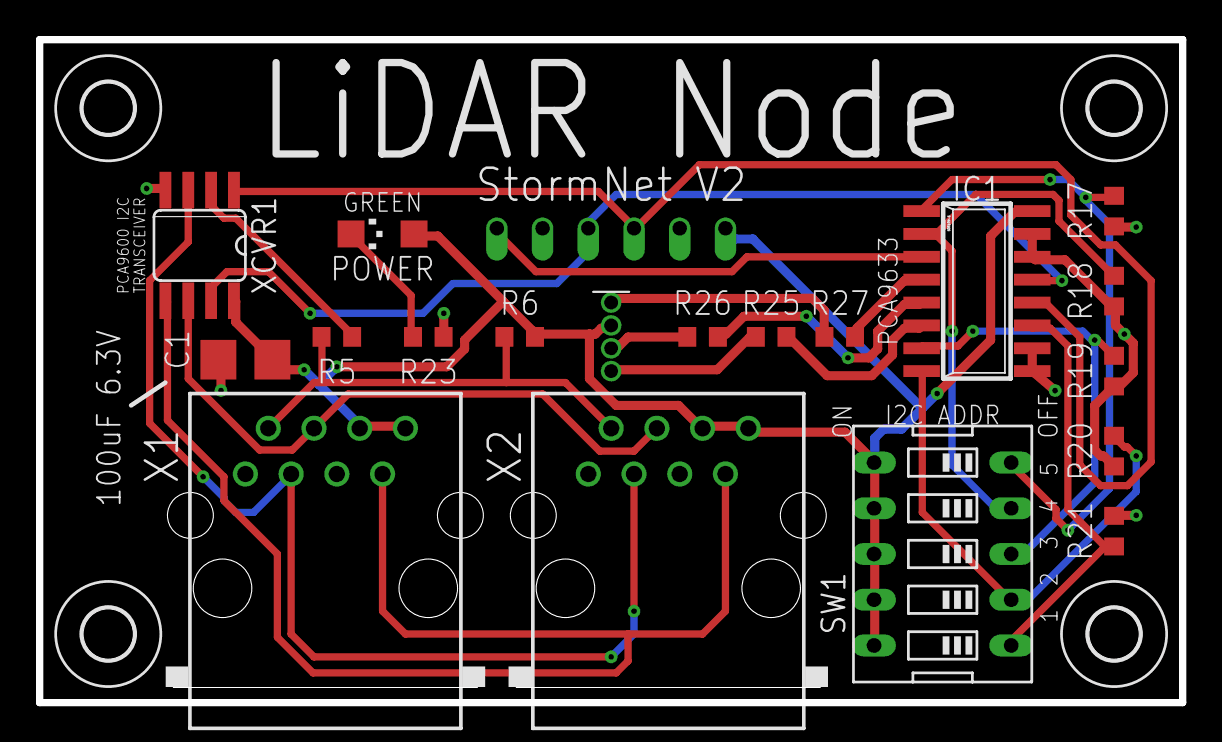
[picture p71: board StormNet18-Remote-v0.1.brd from above]

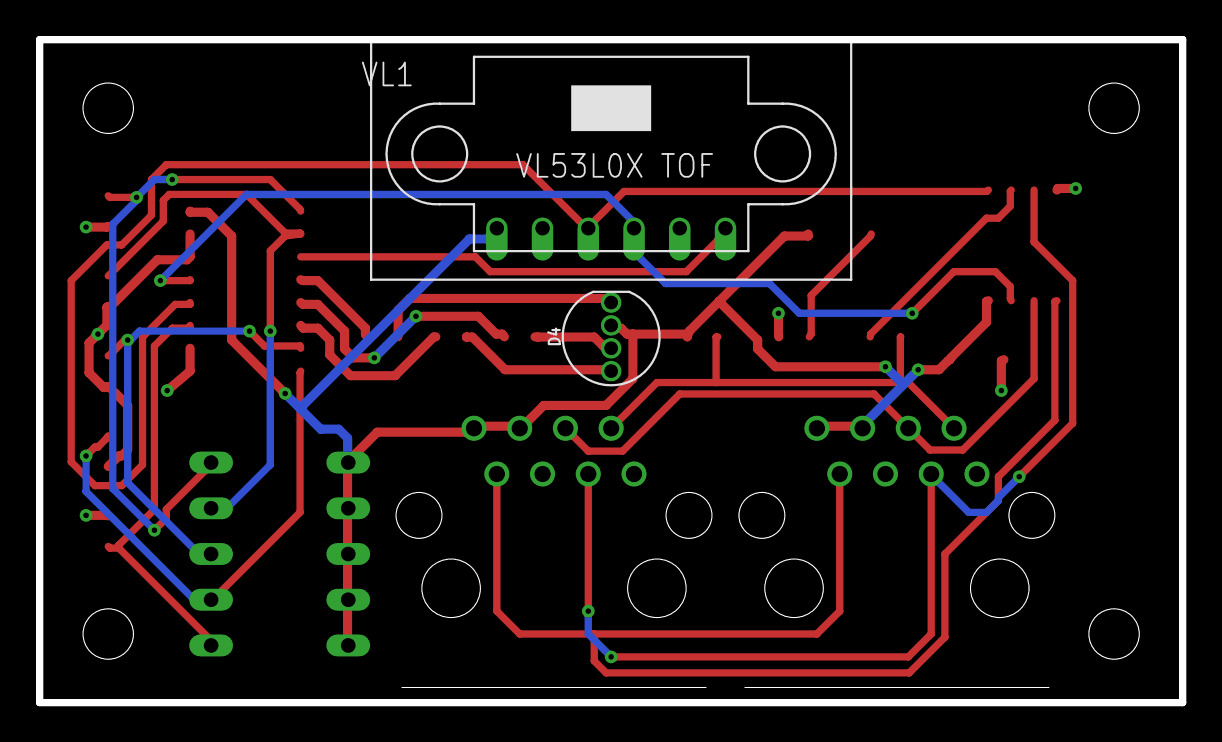
[picture p72: board StormNet18-Remote-v0.1.brd from below]

Board: 2 copper layers, 63.5 x 36.8 mm, 24 parts (2 on the bottom side), 22 nets.

Other parts of the board:
U$5, U$6, U$7, U$8: 2,8
