Stormgears-FRC-5422/StormNet/2018/StormNetV2-FinalDocs/StormNet Board/Eagle7.7.0 CAD files/StormNet18-v0.1.brd

## EAGLE design 2018/StormNetV2-FinalDocs/StormNet Board/Eagle7.7.0 CAD files/StormNet18-v0.1.brd (2020-01-03)

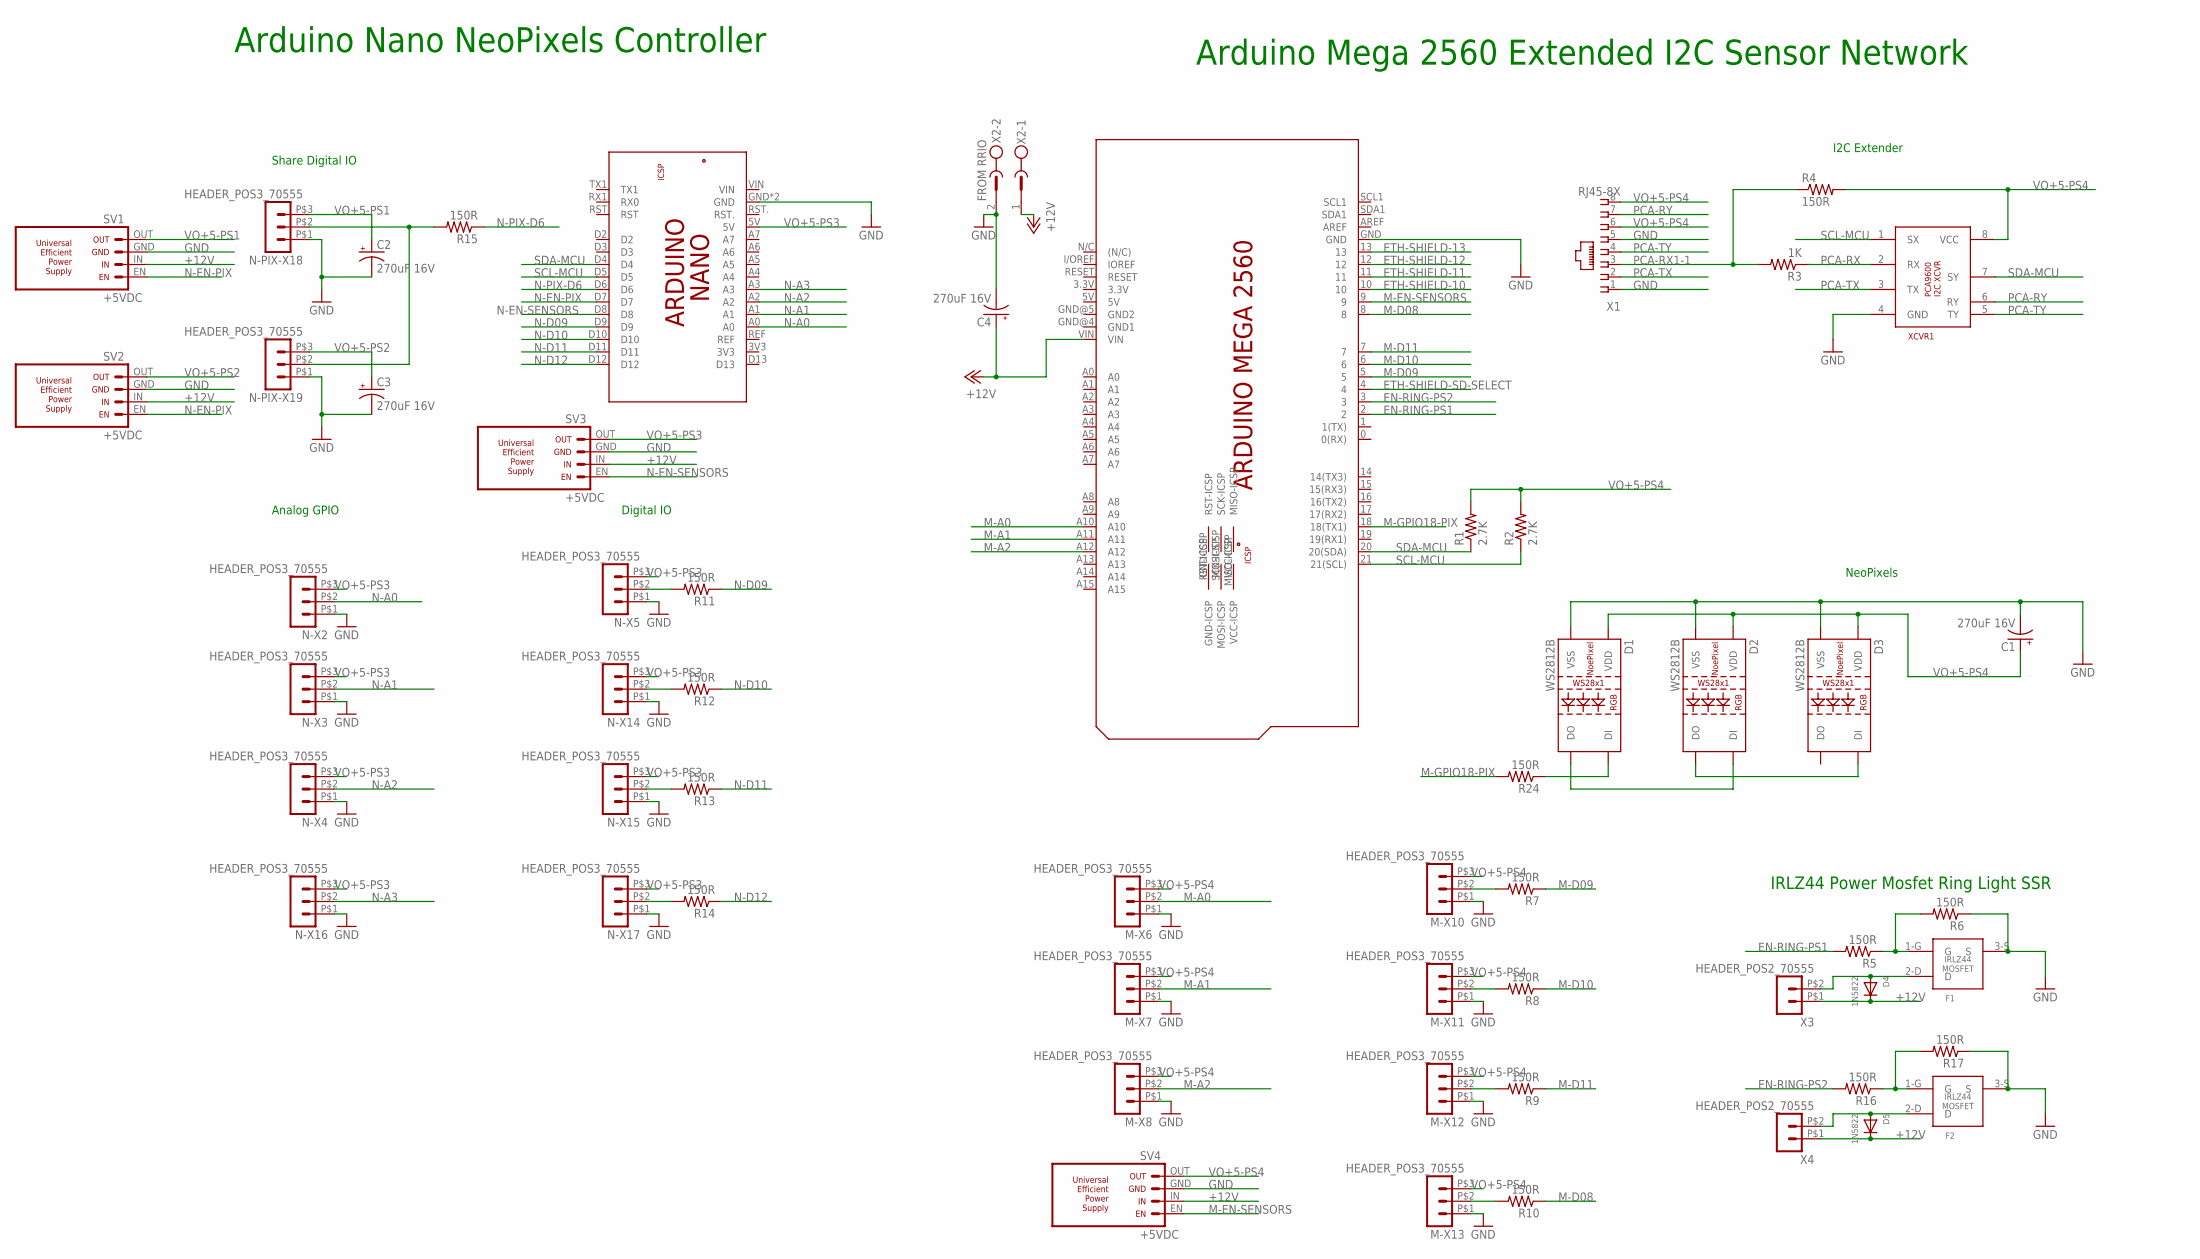
[picture p73: schematic StormNet18-v0.1.sch]

Parts:
C1, C2, C3, C4: 270uF 16V; E3,5-8
D1, D2, D3: WS2812B
D4, D5: 1N5822; SMADIODE
F1, F2: IRLZ44; IRLZ44-TO220
M-X6, M-X7, M-X8, M-X10, M-X11, M-X12, M-X13: HEADER_POS3_70555; 70555-POS3
N-PIX-X18, N-PIX-X19: HEADER_POS3_70555; 70555-POS3
N-X2, N-X3, N-X4, N-X5, N-X14, N-X15, N-X16, N-X17: HEADER_POS3_70555; 70555-POS3
PCB2: ARDUINO_MEGA2560_SMALL
PCB3: ARDUINO_NANOWITHOUT_ICSP; ARDUINO_NANO
R1, R2: 2.7K; R0603
R3: 1K; R0603
R4, R5, R6, R7, R8, R9, R10, R11, R12, R13, R14, R15, R16, R17, R24: 150R; R0603
SV1, SV2, SV3, SV4: +5VDC; PS-UNIV-EFFICIENT-3A
X1: RJ45-8X; RJ45-NO-SHIELD
X2: FROM RRIO; MSTBV2-SMALL
X3, X4: HEADER_POS2_70555; 70555-POS2
XCVR1: PCA9600DSO8; SO08

Connections:
3.3V: PCB2.3.3V
5V: PCB2.5V
+12V: C4.+, D4.C, D5.C, PCB2.VIN, SV1.IN, SV2.IN, SV3.IN, SV4.IN, X2.1, X3.P$1 (1), X4.P$1 (1)
EN-RING-PS1: PCB2.2, R5.2
EN-RING-PS2: PCB2.3, R16.2
ETH-SHIELD-10: PCB2.10
ETH-SHIELD-11: PCB2.11
ETH-SHIELD-12: PCB2.12
ETH-SHIELD-13: PCB2.13
ETH-SHIELD-SD-SELECT: PCB2.4
GND: C1.-, C2.-, C3.-, C4.-, D1.3 (VSS), D2.3 (VSS), D3.3 (VSS), F1.3-S (S), F2.3-S (S), M-X6.P$1 (1), M-X7.P$1 (1), M-X8.P$1 (1), M-X10.P$1 (1), M-X11.P$1 (1), M-X12.P$1 (1), M-X13.P$1 (1), N-PIX-X18.P$1 (1), N-PIX-X19.P$1 (1), N-X2.P$1 (1), N-X3.P$1 (1), N-X4.P$1 (1), N-X5.P$1 (1), N-X14.P$1 (1), N-X15.P$1 (1), N-X16.P$1 (1), N-X17.P$1 (1), PCB2.GND, PCB3.GND, PCB3.GND@1 (GND), R6.1, R17.1, SV1.GND, SV2.GND, SV3.GND, SV4.GND, X1.1, X1.5, X2.2, XCVR1.4 (GND)
GND1: PCB2.GND@4 (GND1)
GND2: PCB2.GND@5 (GND2)
M-A0: M-X6.P$2 (2), PCB2.A10
M-A1: M-X7.P$2 (2), PCB2.A11
M-A2: M-X8.P$2 (2), PCB2.A12
M-D08: PCB2.8, R10.1
M-D09: PCB2.5, R7.1
M-D10: PCB2.6, R8.1
M-D11: PCB2.7, R9.1
M-EN-SENSORS: PCB2.9, SV4.EN
M-GPIO18-PIX: PCB2.18 (18(TX1)), R24.2
unnamed: M-X10.P$2 (2), R7.2
unnamed: N-PIX-X18.P$2 (2), N-PIX-X19.P$2 (2), R15.2
unnamed: M-X11.P$2 (2), R8.2
unnamed: M-X12.P$2 (2), R9.2
unnamed: M-X13.P$2 (2), R10.2
unnamed: F1.1-G (G), R5.1, R6.2
unnamed: D4.A, F1.2-D (D), X3.P$2 (2)
unnamed: N-X5.P$2 (2), R11.2
unnamed: N-X14.P$2 (2), R12.2
unnamed: N-X15.P$2 (2), R13.2
unnamed: N-X17.P$2 (2), R14.2
unnamed: F2.1-G (G), R16.1, R17.2
unnamed: D5.A, F2.2-D (D), X4.P$2 (2)
unnamed: D1.4 (DI), R24.1
unnamed: D2.2 (DO), D3.4 (DI)
unnamed: D1.2 (DO), D2.4 (DI)
N-A0: N-X2.P$2 (2), PCB3.A0
N-A1: N-X3.P$2 (2), PCB3.A1
N-A2: N-X4.P$2 (2), PCB3.A2
N-A3: N-X16.P$2 (2), PCB3.A3
N-D09: PCB3.D9, R11.1
N-D10: PCB3.D10, R12.1
N-D11: PCB3.D11, R13.1
N-D12: PCB3.D12, R14.1
N-EN-PIX: PCB3.D7, SV1.EN, SV2.EN
N-EN-SENSORS: PCB3.D8, SV3.EN
N-PIX-D6: PCB3.D6, R15.1
PCA-RX: R3.1, XCVR1.2 (RX)
PCA-RX1-1: R3.2, R4.1, X1.3
PCA-RY: X1.7, XCVR1.6 (RY)
PCA-TX: X1.2, XCVR1.3 (TX)
PCA-TY: X1.4, XCVR1.5 (TY)
SCL-MCU: PCB2.21 (21(SCL)), PCB3.D5, R2.1, XCVR1.1 (SX)
SDA-MCU: PCB2.20 (20(SDA)), PCB3.D4, R1.1, XCVR1.7 (SY)
VO+5-PS1: C2.+, N-PIX-X18.P$3 (3), SV1.OUT
VO+5-PS2: C3.+, N-PIX-X19.P$3 (3), SV2.OUT
VO+5-PS3: N-X2.P$3 (3), N-X3.P$3 (3), N-X4.P$3 (3), N-X5.P$3 (3), N-X14.P$3 (3), N-X15.P$3 (3), N-X16.P$3 (3), N-X17.P$3 (3), PCB3.5V, SV3.OUT
VO+5-PS4: C1.+, D1.1 (VDD), D2.1 (VDD), D3.1 (VDD), M-X6.P$3 (3), M-X7.P$3 (3), M-X8.P$3 (3), M-X10.P$3 (3), M-X11.P$3 (3), M-X12.P$3 (3), M-X13.P$3 (3), R1.2, R2.2, R4.2, SV4.OUT, X1.6, X1.8, XCVR1.8 (VCC)

Notes on the sheet:
Arduino Mega 2560 Extended I2C Sensor Network
Arduino Nano NeoPixels Controller
Share Digital IO
Analog GPIO
Digital IO
NeoPixels
I2C Extender
IRLZ44 Power Mosfet Ring Light SSR

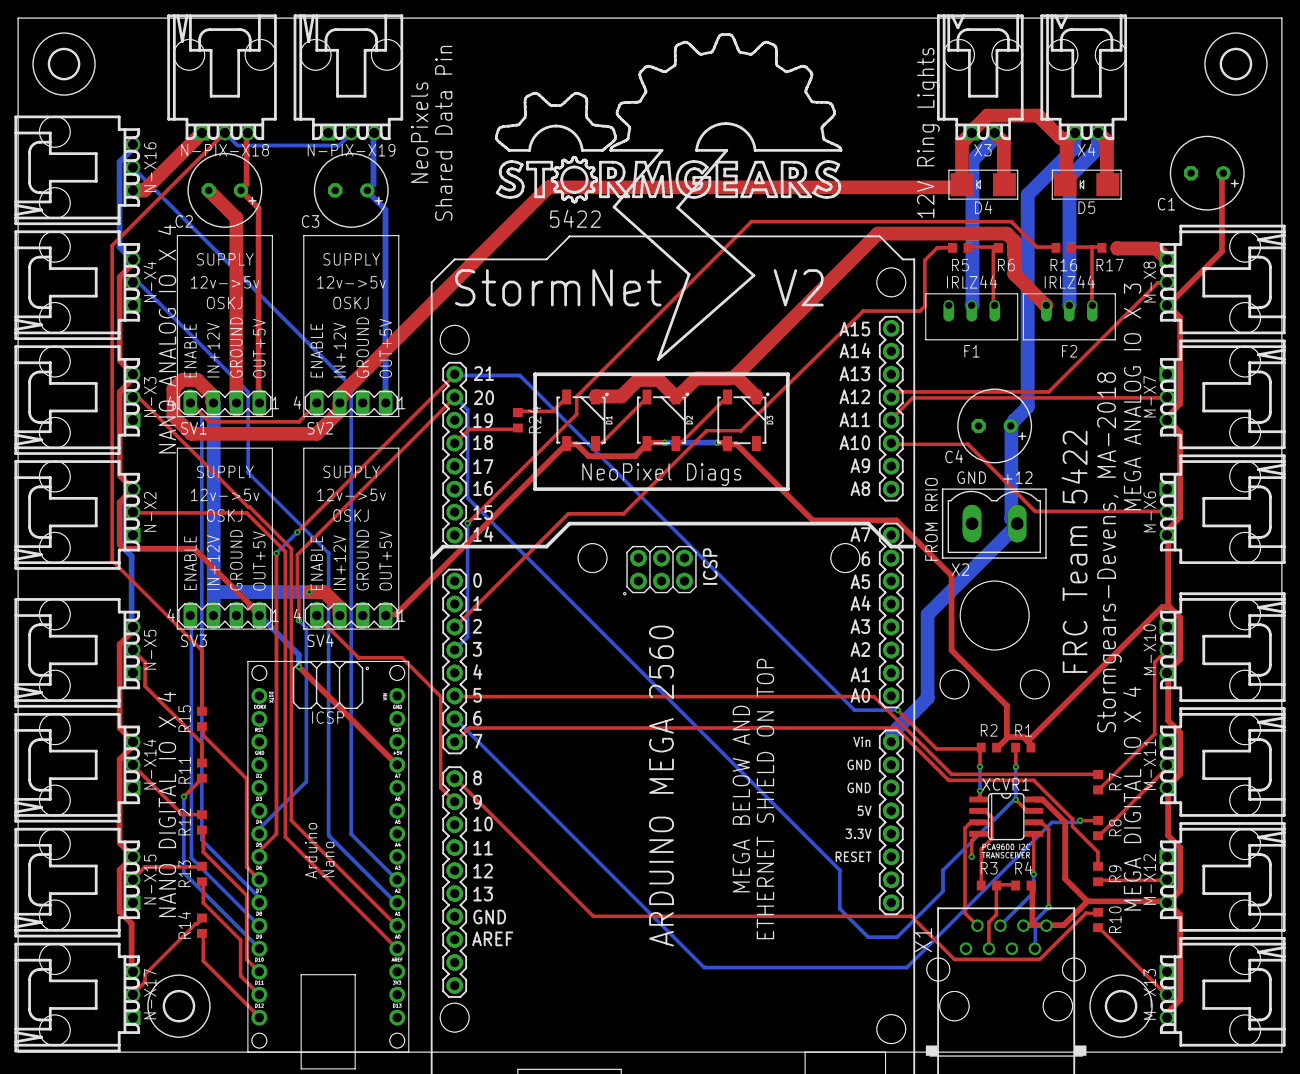
[picture p74: board StormNet18-v0.1.brd from above]

Board: 2 copper layers, 139.7 x 114.3 mm, 61 parts (0 on the bottom side), 51 nets.

Other parts of the board:
U$1, U$2, U$3, U$4: 3,2
